MatteoLonardiUNITN/Tesi-SPaRKLE/Grafici/MCD Picchi/mcd_picchi.Rmd

---
title: "MDC Picchi"
author: "Matteo Lonardi"
date: "2026-03-17"
output: html_document
---

```{r setup, include=FALSE}
knitr::opts_chunk$set(echo = TRUE)
library(tidyverse)
library(scales) # Per gestire meglio le scale dei grafici
library(plotly)
library(tidyverse)
library(modelr)
library(minpack.lm)
```

```{r}
# Libreria
library(plotly)

# -----------------------------
# Funzione MCD
# -----------------------------
mcd <- function(a, b) {
  if (b == 0) return(a)
  Recall(b, a %% b)
}

mcd_vettore <- function(v) {
  Reduce(mcd, v)
}

# -----------------------------
# Lista file
# -----------------------------
files <- sprintf("files/tek%04dCH1.csv", 21:59)

# -----------------------------
# Estrazione massimi
# -----------------------------
massimi <- sapply(files, function(f) {
  dati <- read.csv(f, skip = 20)
  max(dati$CH1, na.rm = TRUE)
})

soglia_max <- 0.004

massimi_filtrati <- massimi[massimi <= soglia_max]

# Rimuovi eventuali NA
massimi_filtrati <- na.omit(massimi_filtrati)

cat("Massimi filtrati:\n")
print(massimi_filtrati)

# -----------------------------
# MCD sui dati filtrati
# -----------------------------
scala <- 1e6   # microvolt
massimi_int <- round(massimi_filtrati * scala)

mcd_val <- mcd_vettore(massimi_int)
mcd_volt <- mcd_val / scala

cat("MCD (volt):", mcd_volt, "\n")

# -----------------------------
# Istogramma
# -----------------------------
nbins <- 20

fig <- plot_ly(
  x = massimi_filtrati,
  type = "histogram",
  nbinsx = nbins
)

fig <- fig %>% layout(
  title = "Istogramma dei picchi massimi filtrati (CH1)",
  xaxis = list(title = "Tensione (V)"),
  yaxis = list(title = "Conteggi")
)

fig
```

```{r}
# Librerie
library(plotly)

# -----------------------------
# 1. Lista file
# -----------------------------
files <- sprintf("files/tek%04dCH1.csv", 21:59)

# -----------------------------
# 2. Estrazione massimi
# -----------------------------
massimi <- sapply(files, function(f) {
  dati <- read.csv(f, skip = 20)
  max(dati$CH1, na.rm = TRUE)
})

massimi <- na.omit(massimi)

cat("Massimi originali:\n")
print(massimi)

# -----------------------------
# 3. Filtro (togli outlier > 0.002 V)
# -----------------------------
soglia_max <- 0.002
massimi_filtrati <- massimi[massimi <= soglia_max]

cat("Massimi filtrati:\n")
print(massimi_filtrati)

# -----------------------------
# 4. Clustering (4 celle)
# -----------------------------
set.seed(1)
k <- kmeans(massimi_filtrati, centers = 4)

# Centri dei cluster (ordinati)
centri <- sort(k$centers[,1])

cat("Centri cluster (V):\n")
print(centri)

# -----------------------------
# 5. Stima tensione cella
# -----------------------------
differenze <- diff(centri)

cat("Differenze tra cluster:\n")
print(differenze)

cella <- median(differenze)

cat("Stima tensione cella (V):", cella, "\n")

# -----------------------------
# 6. Istogramma con linee cluster
# -----------------------------
nbins <- 50

fig <- plot_ly(
  x = massimi_filtrati,
  type = "histogram",
  nbinsx = nbins
)

# Creazione linee verticali
shapes_list <- lapply(centri, function(c) {
  list(
    type = "line",
    x0 = c,
    x1 = c,
    y0 = 0,
    y1 = 1,
    yref = "paper",  # tutta l'altezza del grafico
    line = list(dash = "dash")
  )
})

fig <- fig %>% layout(
  title = "Istogramma + cluster (SiPM)",
  xaxis = list(title = "Tensione (V)"),
  yaxis = list(title = "Conteggi"),
  shapes = shapes_list
)

fig
```
