MatteoLonardiUNITN/Tesi-SPaRKLE/Grafici/LaTeX-graphics/particelle_alpha00.pdf

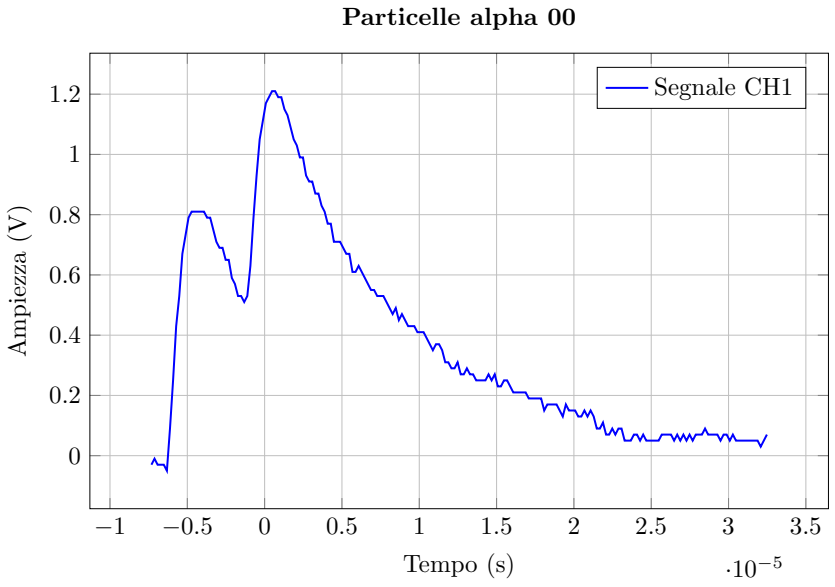
[picture p30: figure]
Tempo (s); Ampiezza (V); Particelle alpha 00; Segnale CH1
