MatteoLonardiUNITN/Tesi-SPaRKLE/Grafici/LaTeX-graphics/particelle_alpha01.pdf

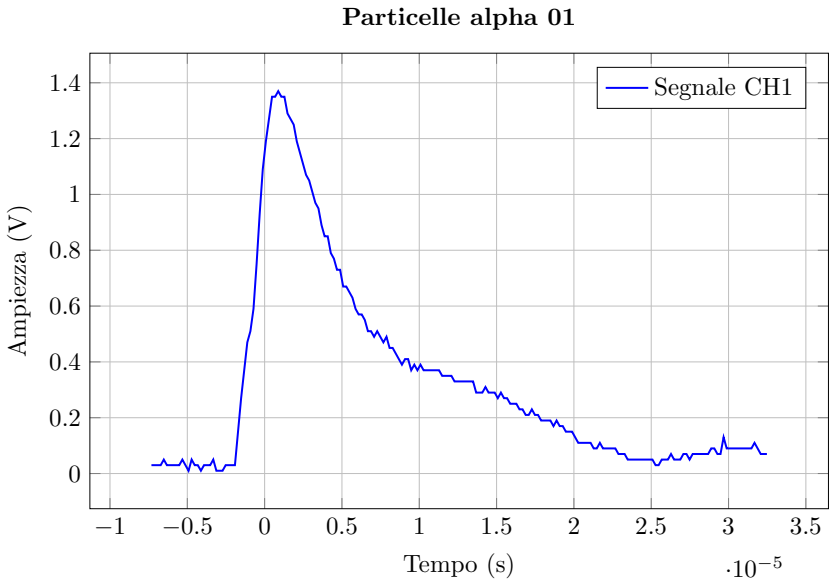
[picture p31: figure]
Tempo (s); Ampiezza (V); Particelle alpha 01; Segnale CH1
