MatteoLonardiUNITN/Tesi-SPaRKLE/Grafici/LaTeX-graphics/particelle_alpha02.pdf

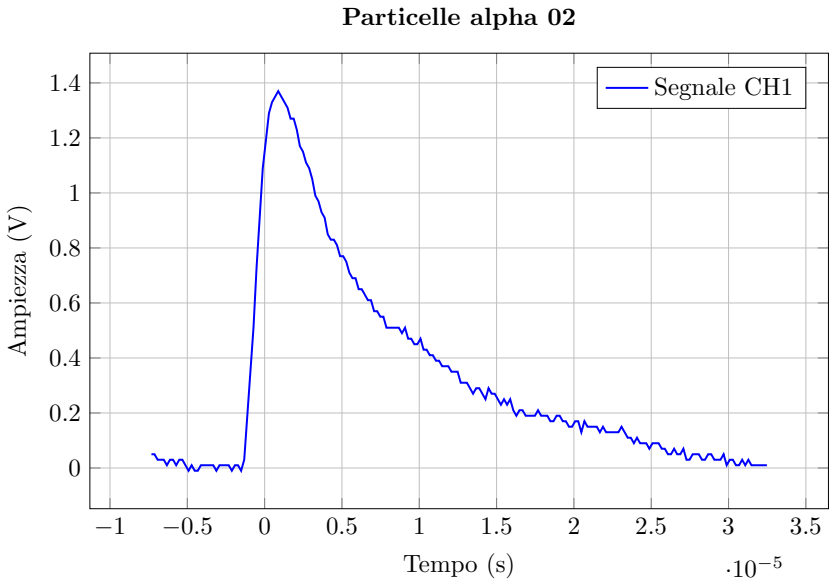
[picture p32: figure]
Tempo (s); Ampiezza (V); Particelle alpha 02; Segnale CH1
