MatteoLonardiUNITN/Tesi-SPaRKLE/Grafici/LaTeX-graphics/particelle_alpha03.pdf

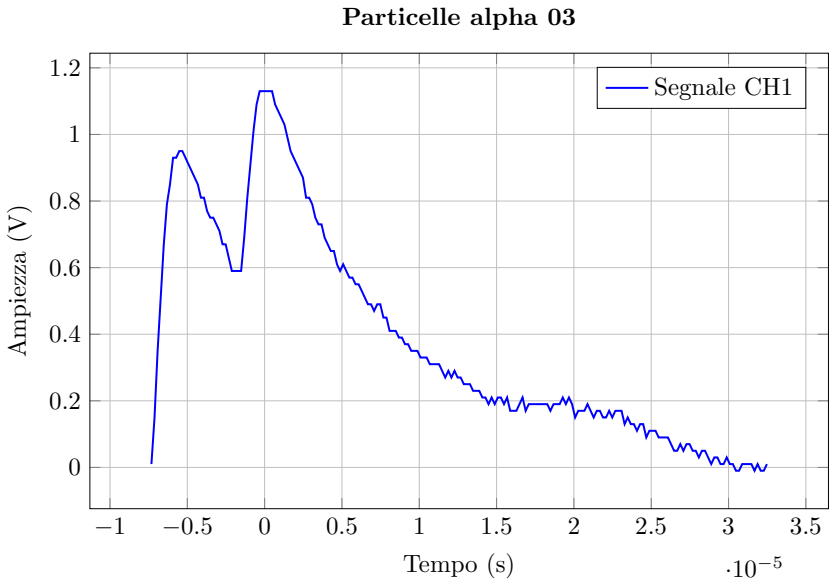
[picture p33: figure]
Tempo (s); Ampiezza (V); Particelle alpha 03; Segnale CH1
