MatteoLonardiUNITN/Tesi-SPaRKLE/Grafici/Regressione/backup_files/tek00000.png

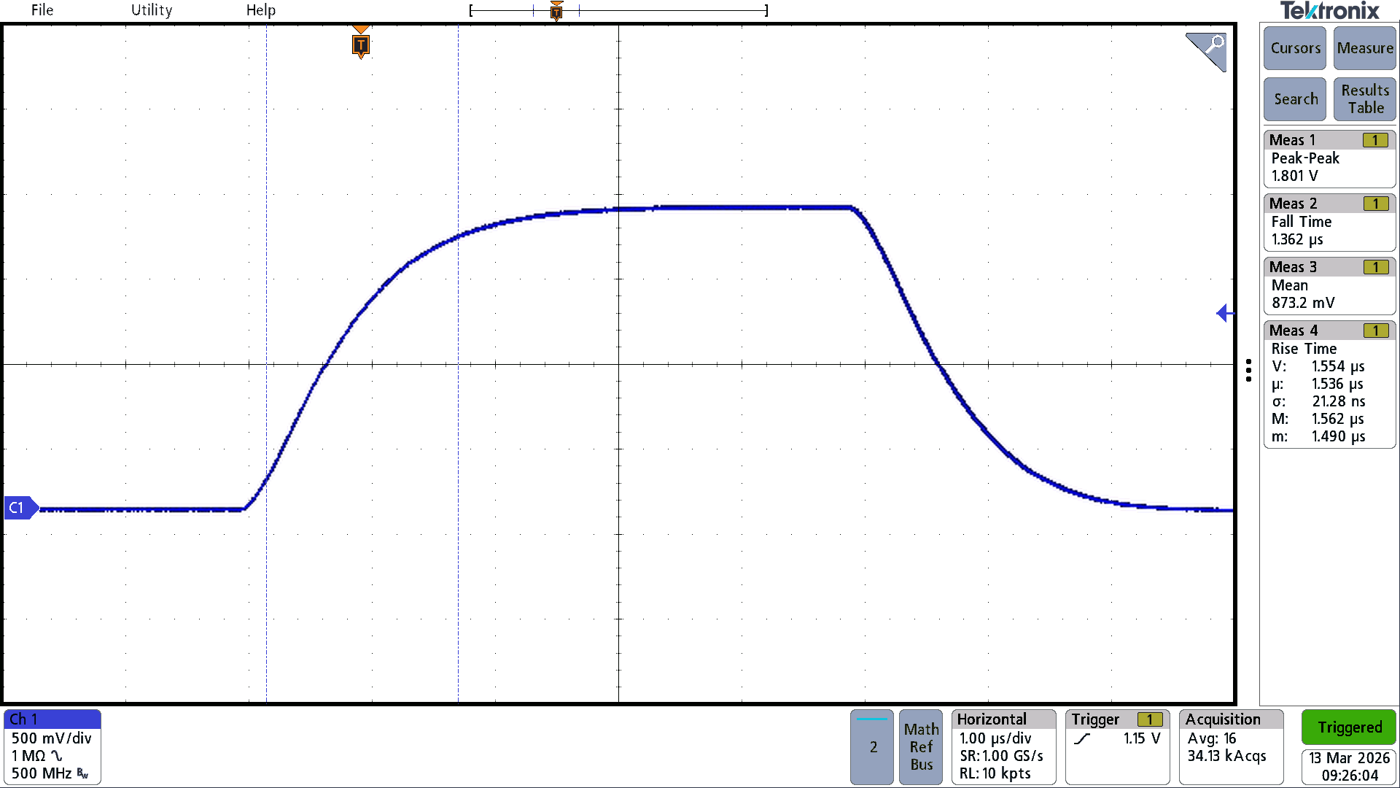
Grafici/Regressione/backup_files/tek00000.png
