MatteoLonardiUNITN/Tesi-SPaRKLE/Grafici/Regressione/backup_files/tek00001.png

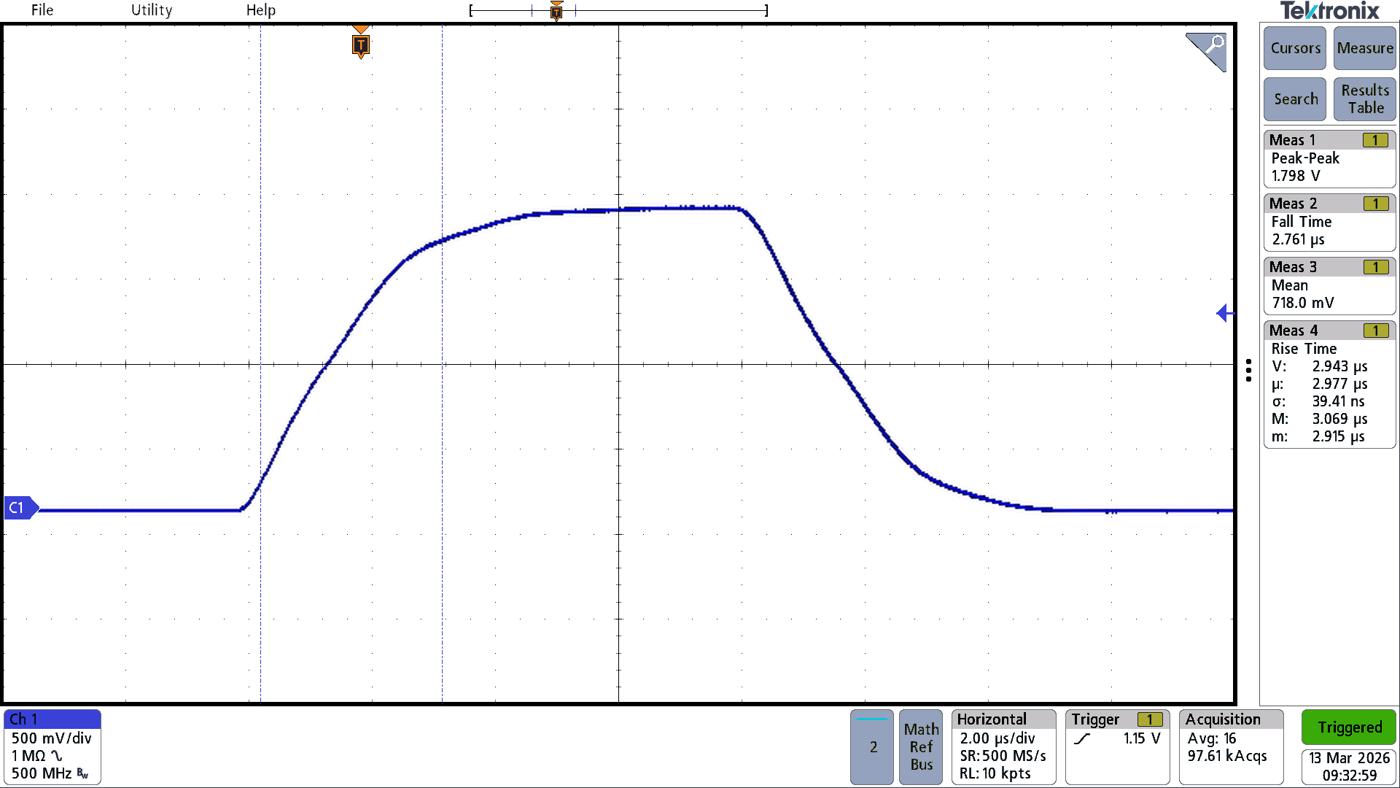
Grafici/Regressione/backup_files/tek00001.png
