MatteoLonardiUNITN/Tesi-SPaRKLE/Grafici/Regressione/backup_files/tek00002.png

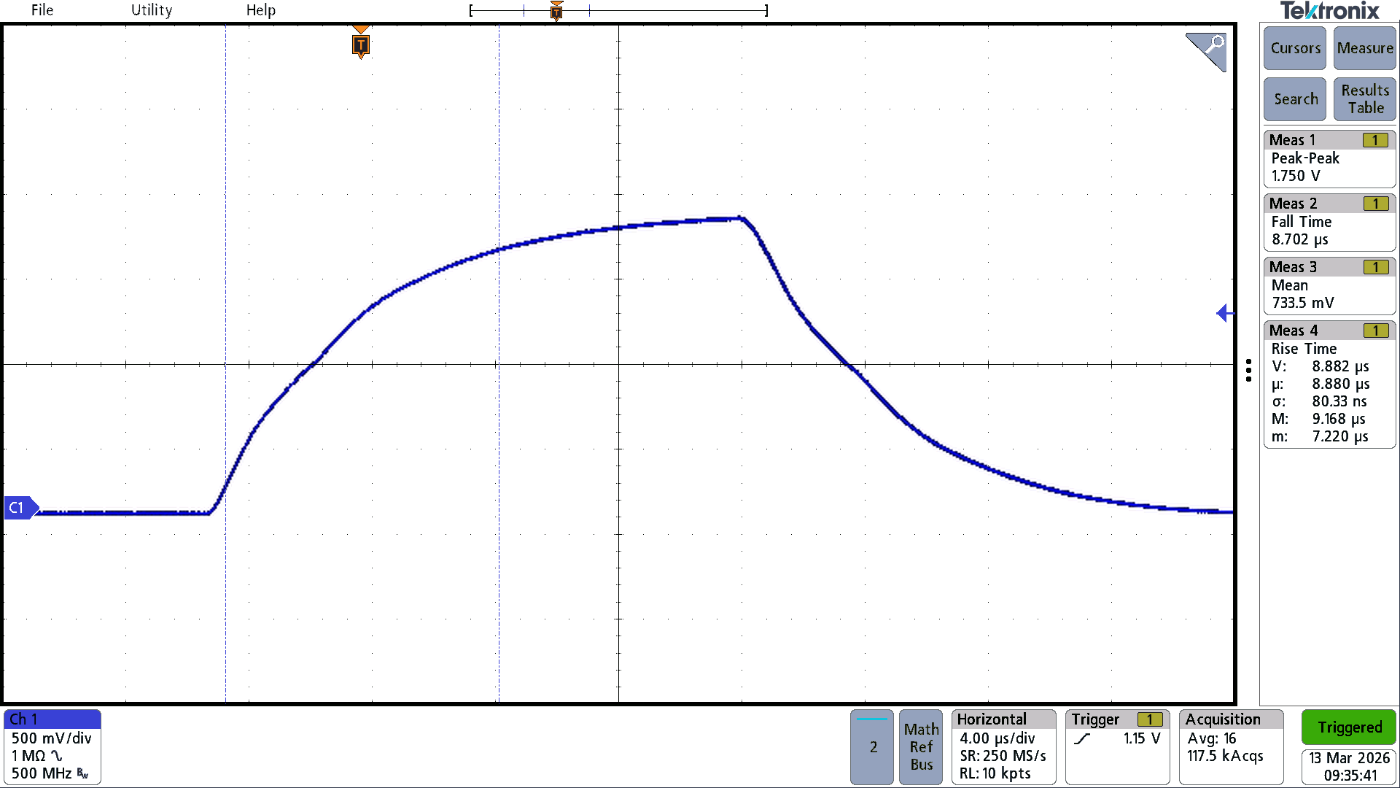
Grafici/Regressione/backup_files/tek00002.png
