MatteoLonardiUNITN/Tesi-SPaRKLE/Grafici/Regressione/backup_files/tek00003.png

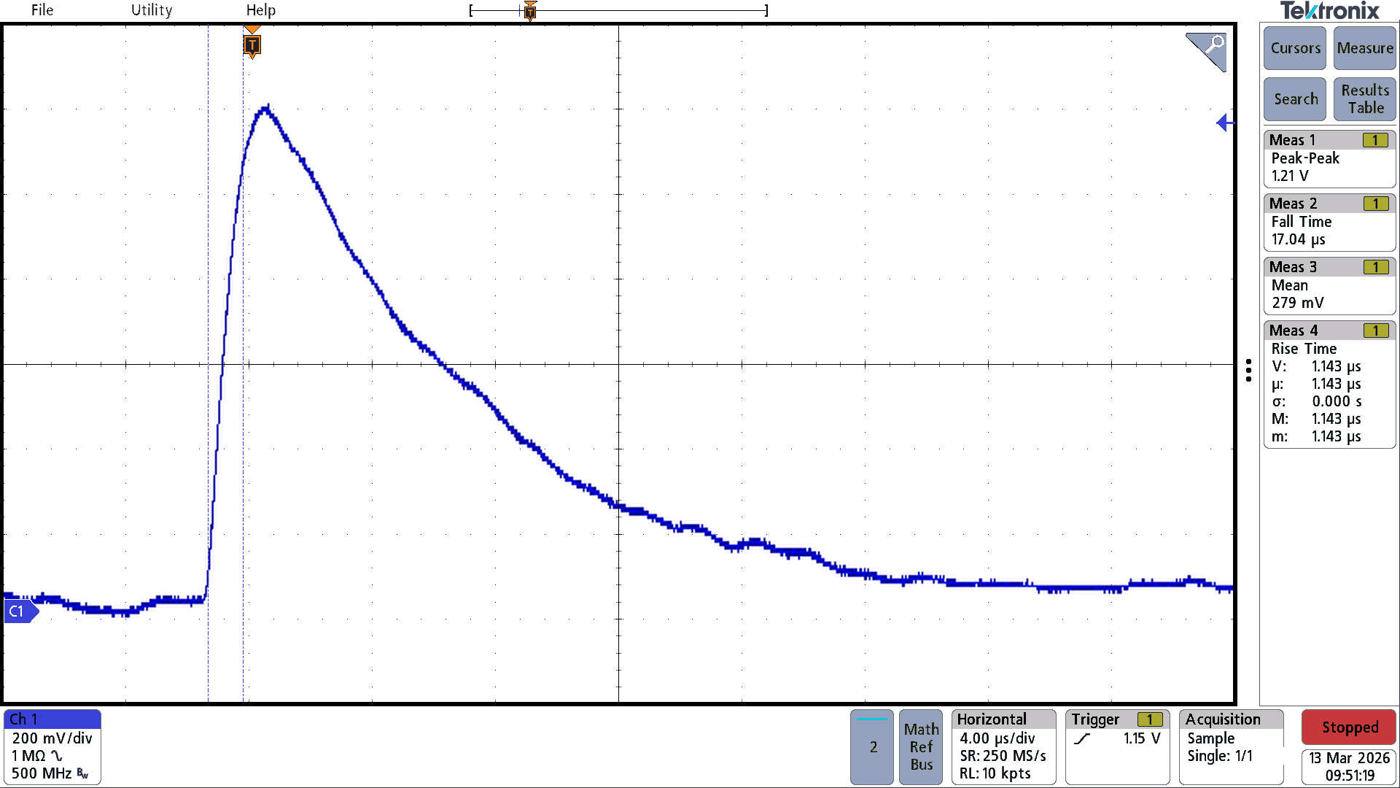
Grafici/Regressione/backup_files/tek00003.png
