MatteoLonardiUNITN/Tesi-SPaRKLE/Grafici/Regressione/backup_files/tek00004.png

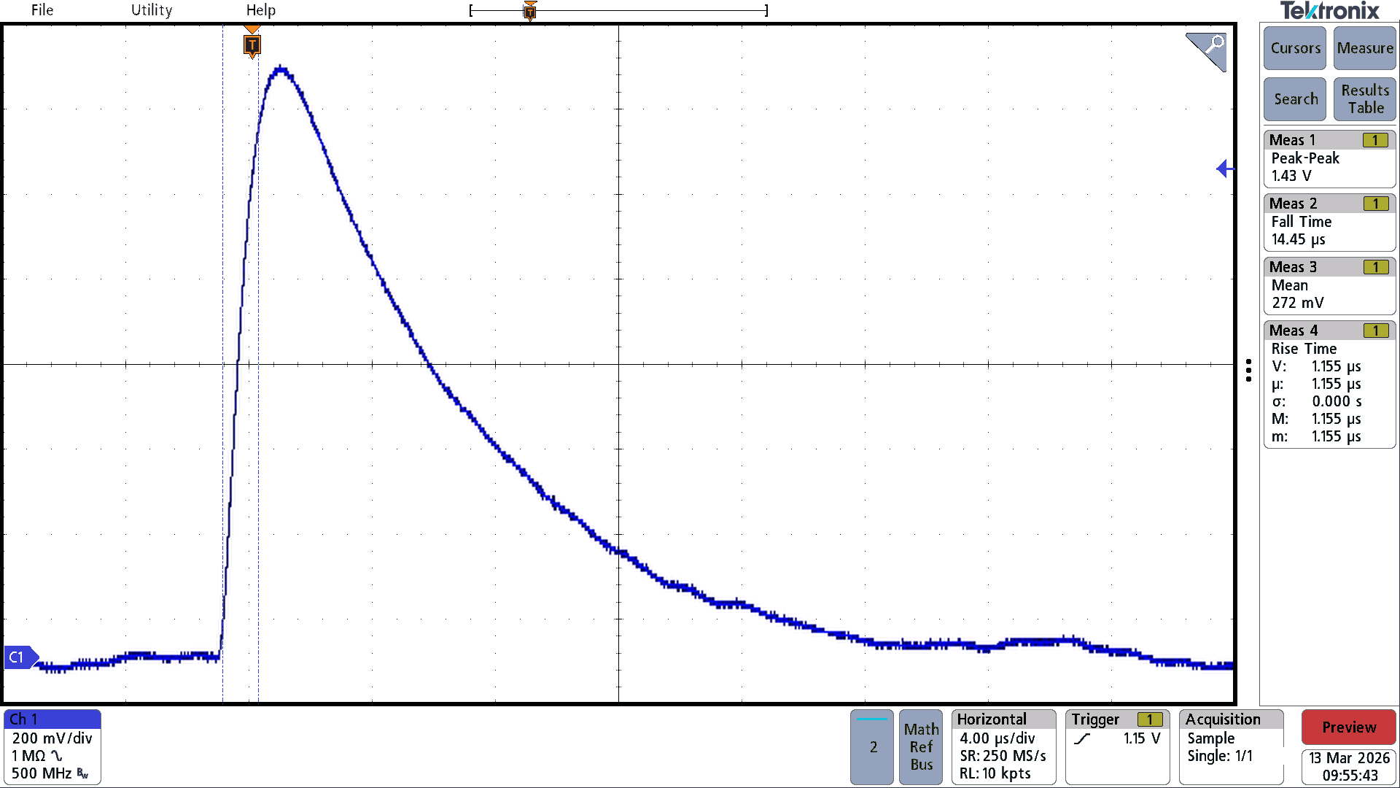
Grafici/Regressione/backup_files/tek00004.png
