MatteoLonardiUNITN/Tesi-SPaRKLE/Grafici/Regressione/Regressione_Caratterizzazione_Completo/confronto_currentmode_voltagemode_8_SiPM.png

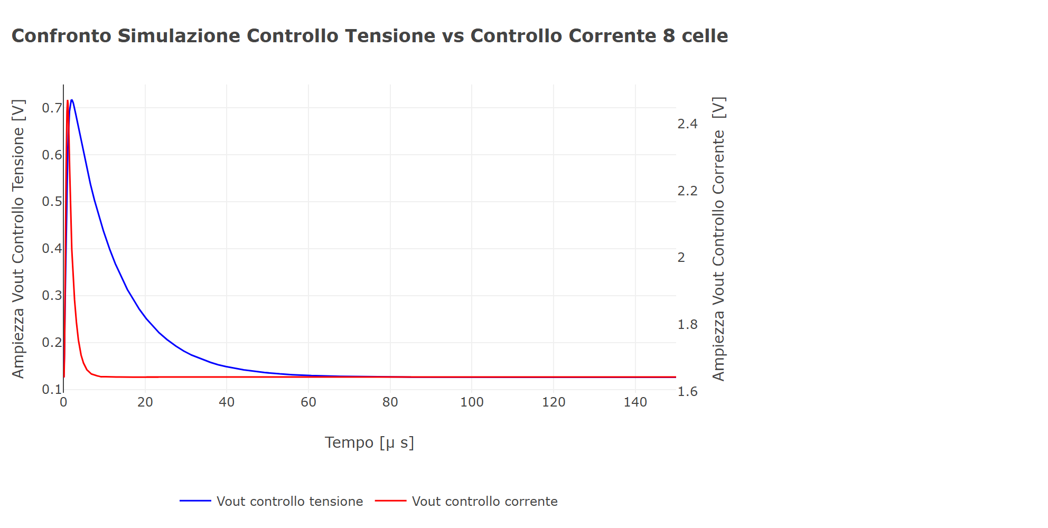
Grafici/Regressione/Regressione_Caratterizzazione_Completo/confronto_currentmode_voltagemode_8_SiPM.png
