MatteoLonardiUNITN/Tesi-SPaRKLE/LaTeX/Immagini/currentmodebode.PNG

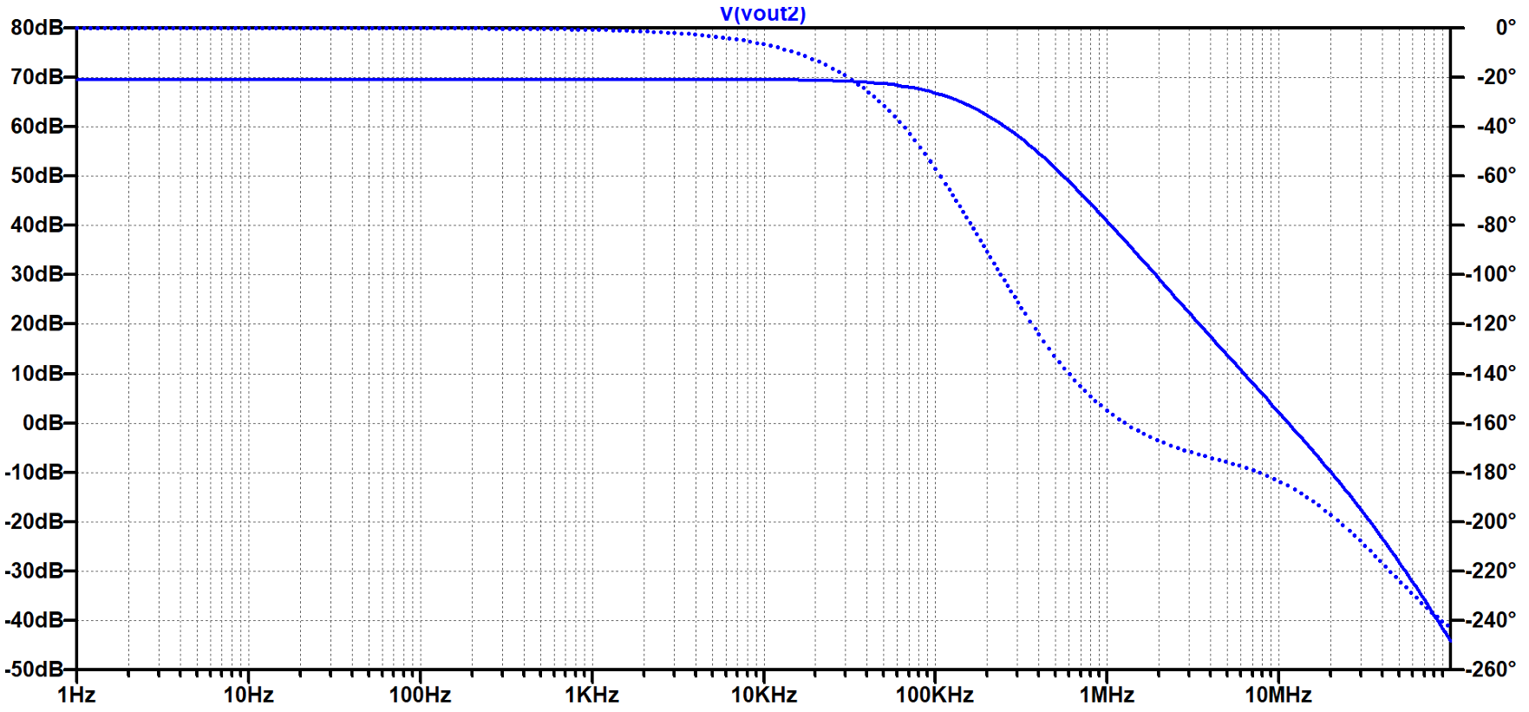
LaTeX/Immagini/currentmodebode.PNG
