MatteoLonardiUNITN/Tesi-SPaRKLE/LaTeX/Immagini/currentmodecircuit.PNG

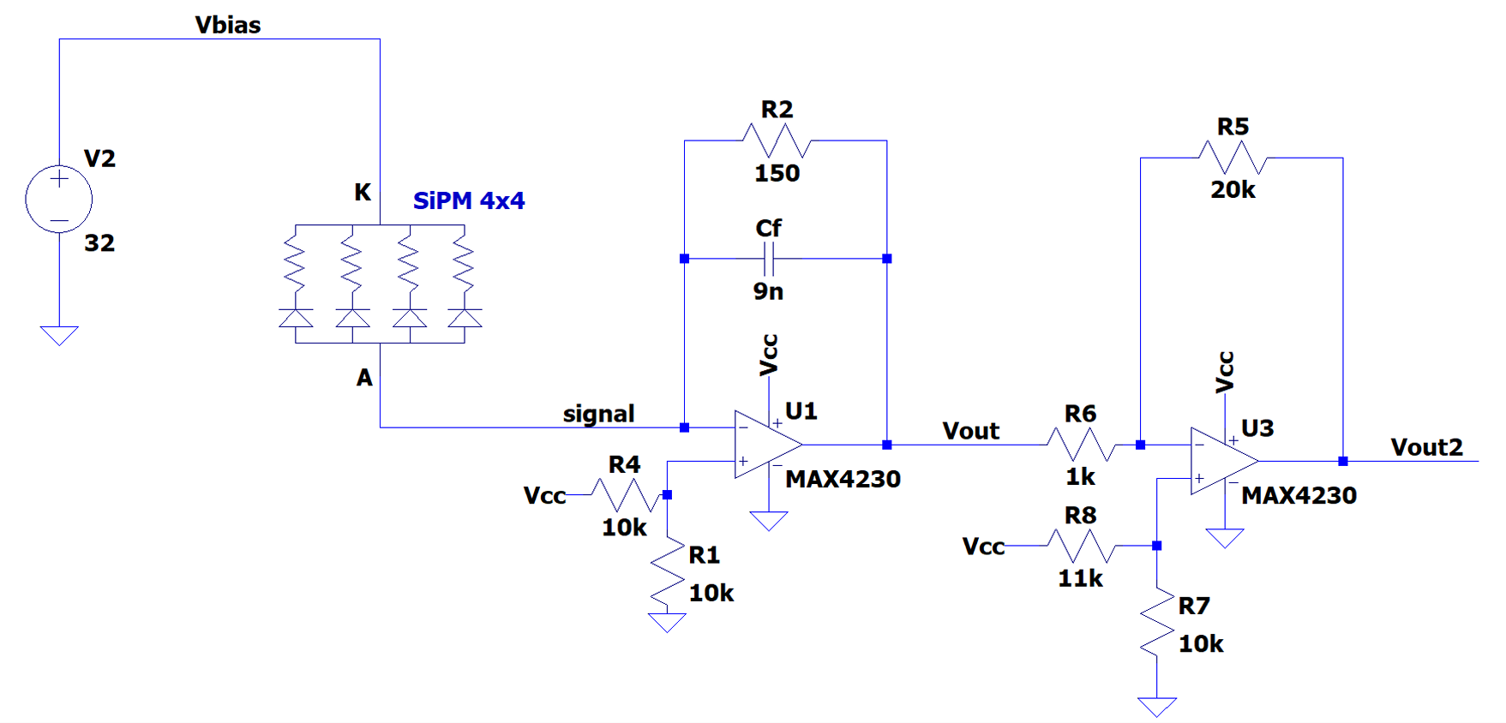
LaTeX/Immagini/currentmodecircuit.PNG
