MatteoLonardiUNITN/Tesi-SPaRKLE/LaTeX/Immagini/currentmodetransient1.PNG

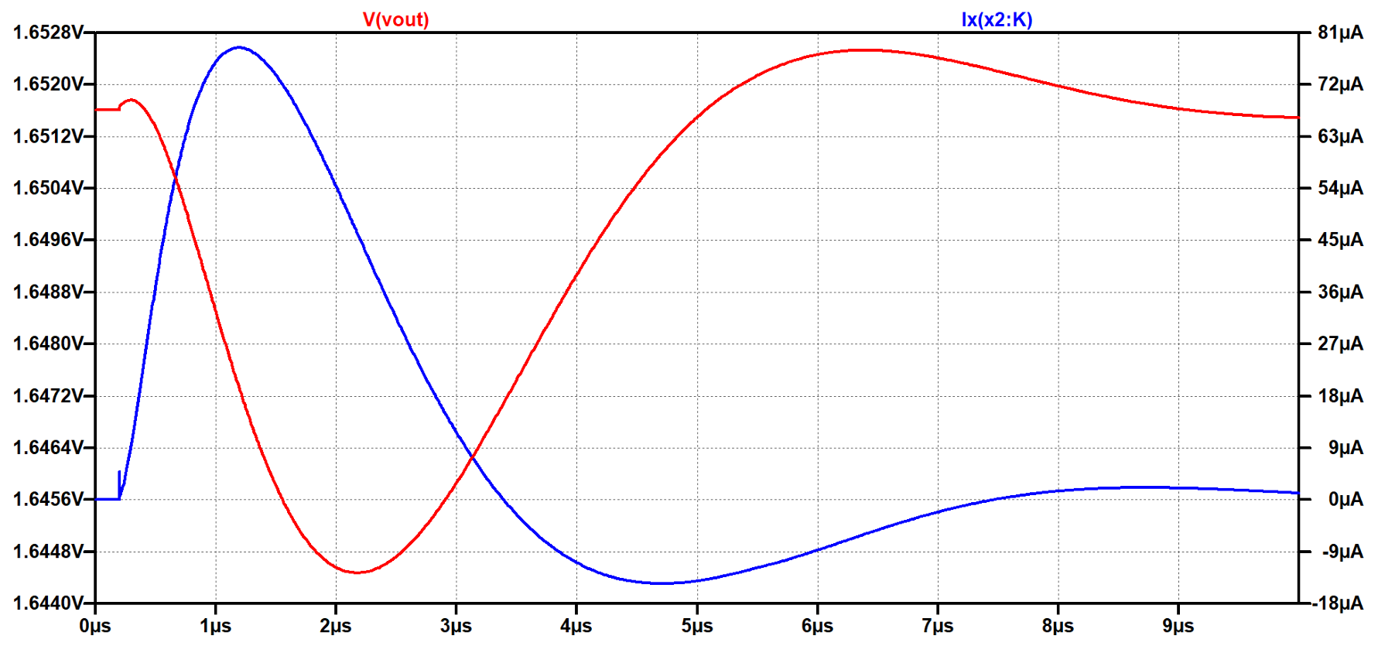
LaTeX/Immagini/currentmodetransient1.PNG
