MatteoLonardiUNITN/Tesi-SPaRKLE/LaTeX/Immagini/currentmodetransient2.PNG

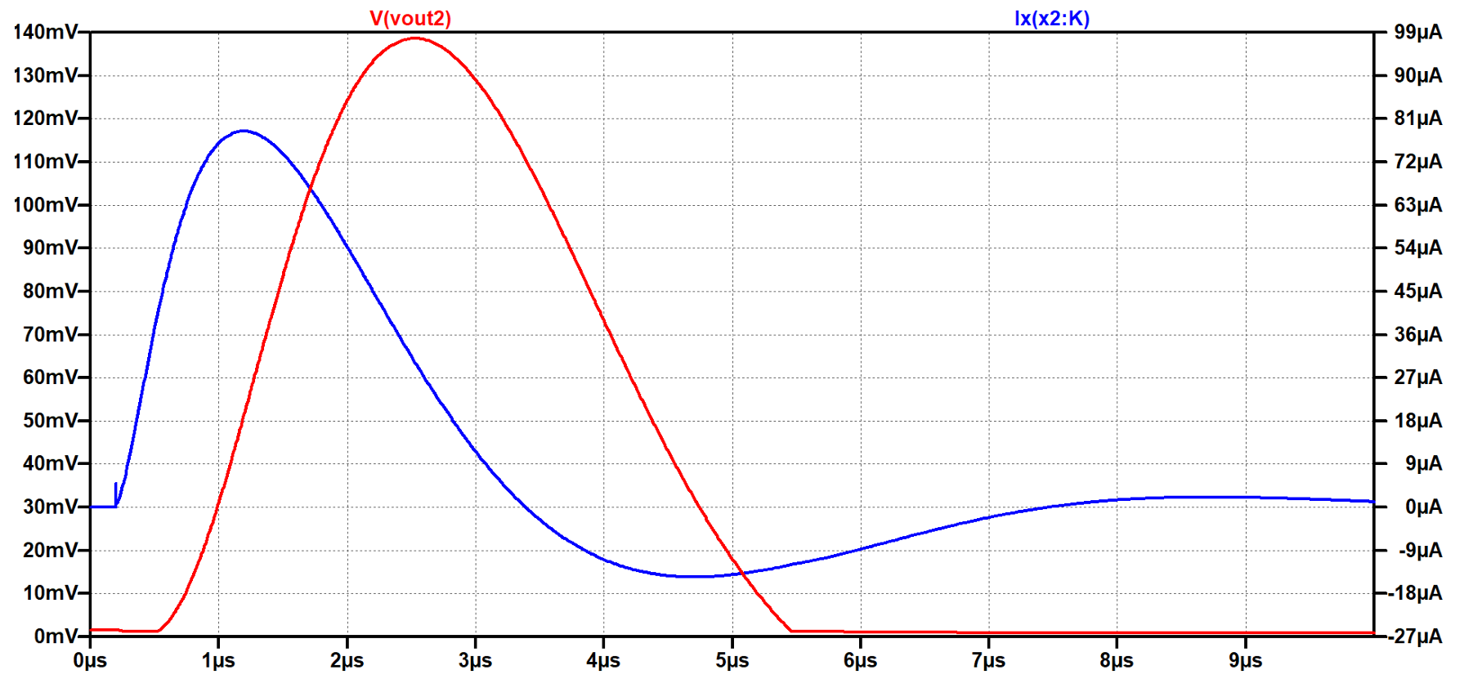
LaTeX/Immagini/currentmodetransient2.PNG
