MatteoLonardiUNITN/Tesi-SPaRKLE/LaTeX/Immagini/gaggimage.PNG

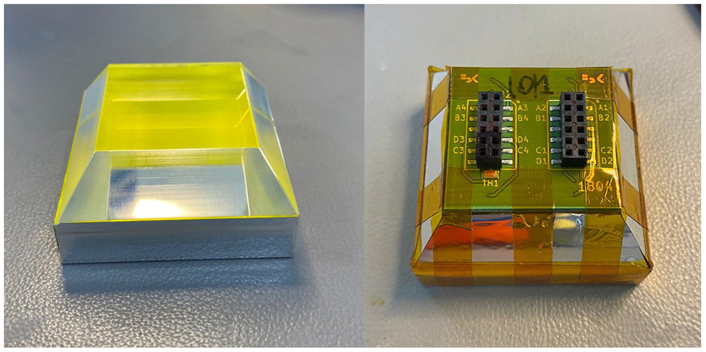
LaTeX/Immagini/gaggimage.PNG
