MatteoLonardiUNITN/Tesi-SPaRKLE/LaTeX/Immagini/mio_circuito_controllo_tensione.png

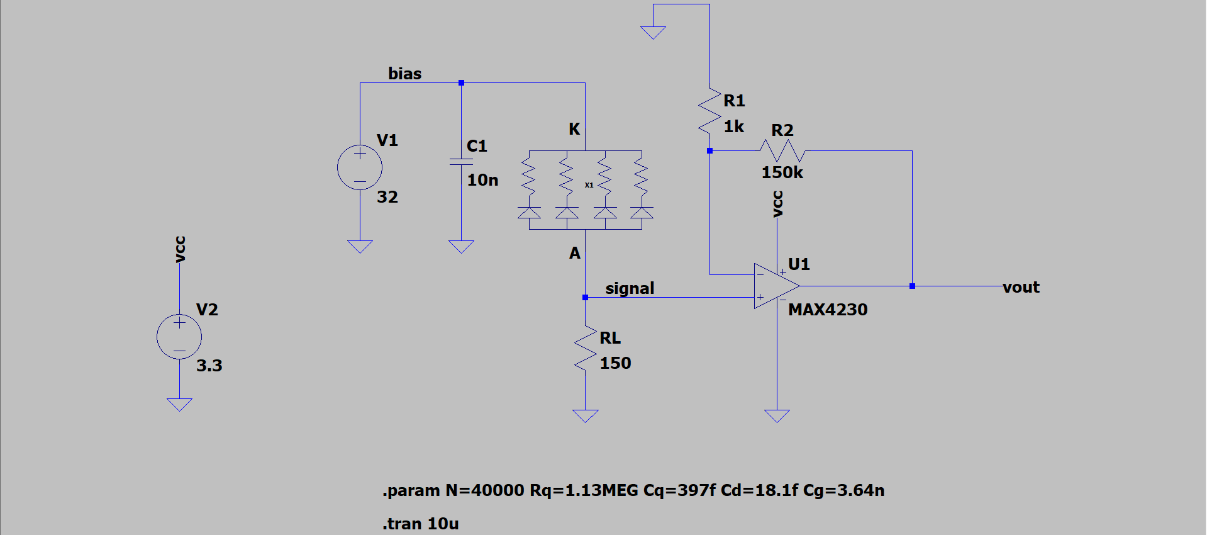
LaTeX/Immagini/mio_circuito_controllo_tensione.png
