MatteoLonardiUNITN/Tesi-SPaRKLE/LaTeX/Immagini/mio_circuito_sipm_equivalente.png

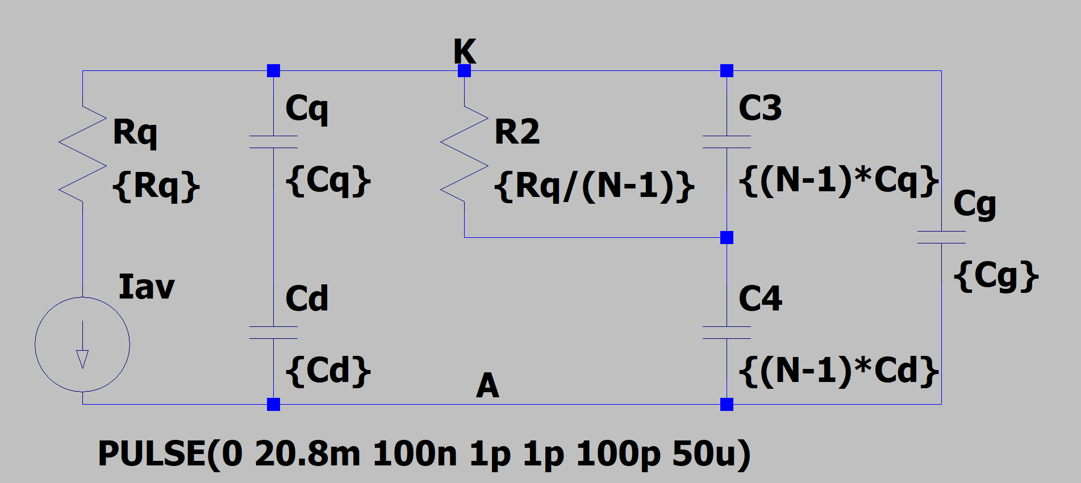
LaTeX/Immagini/mio_circuito_sipm_equivalente.png
