MatteoLonardiUNITN/Tesi-SPaRKLE/LaTeX/Immagini/mio_plot_controllo_corrente.png

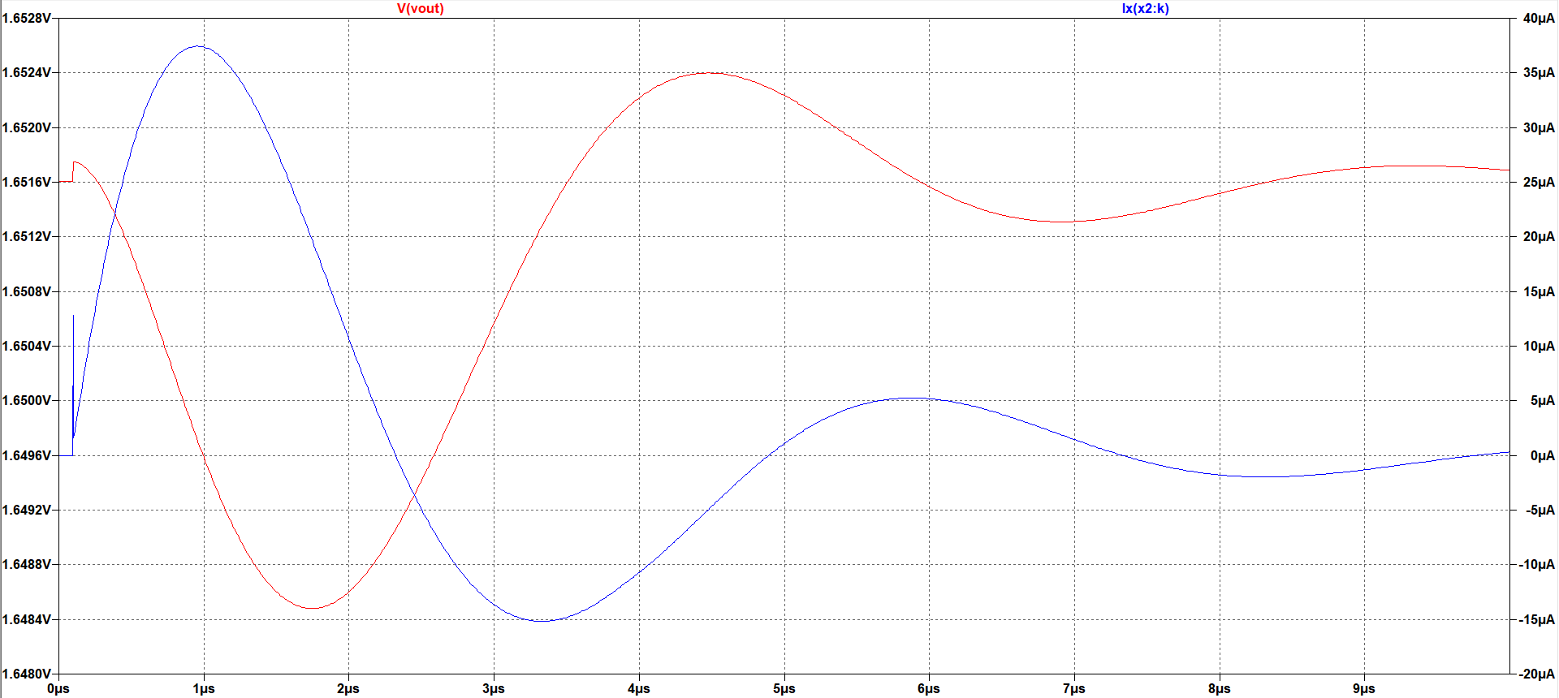
LaTeX/Immagini/mio_plot_controllo_corrente.png
