MatteoLonardiUNITN/Tesi-SPaRKLE/LaTeX/Immagini/mio_plot_controllo_tensione.png

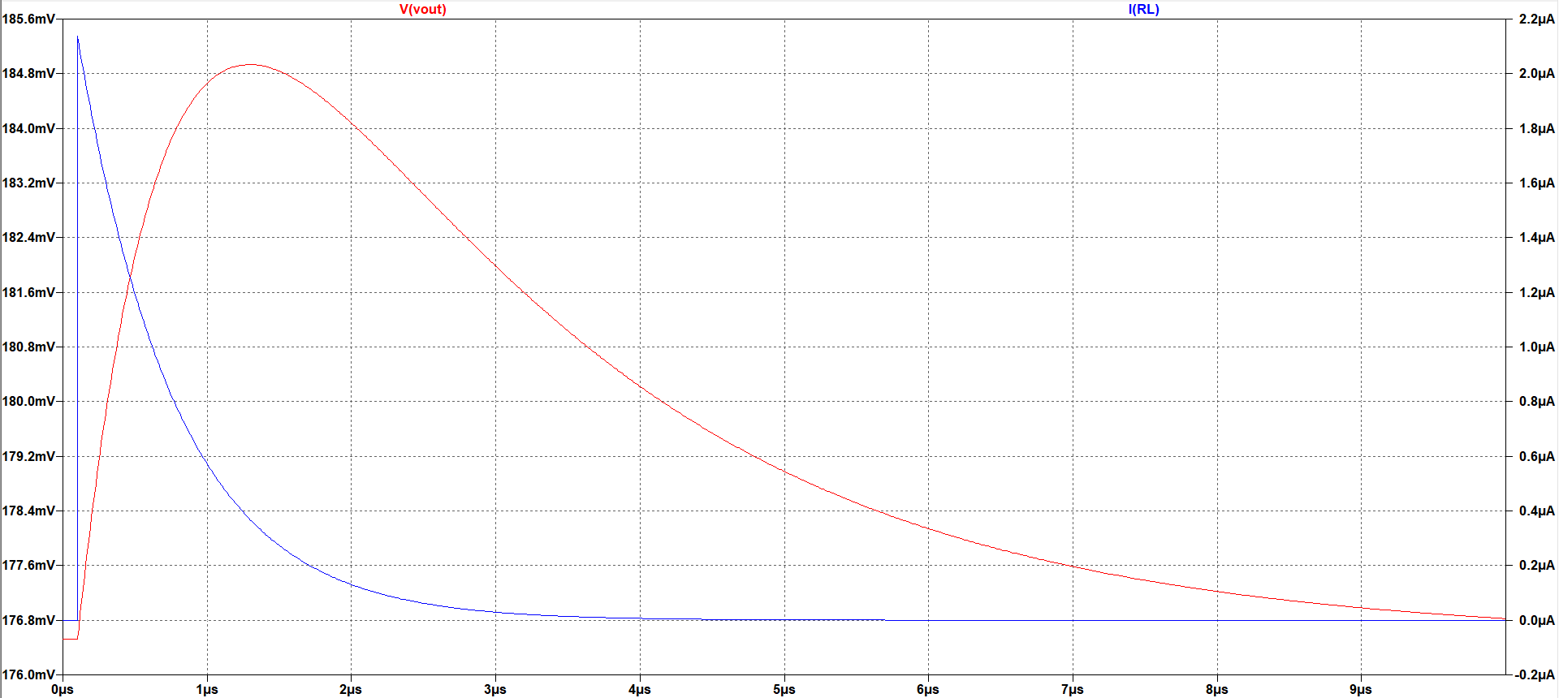
LaTeX/Immagini/mio_plot_controllo_tensione.png
