MatteoLonardiUNITN/Tesi-SPaRKLE/LaTeX/Immagini/voltagemodecircuit.PNG

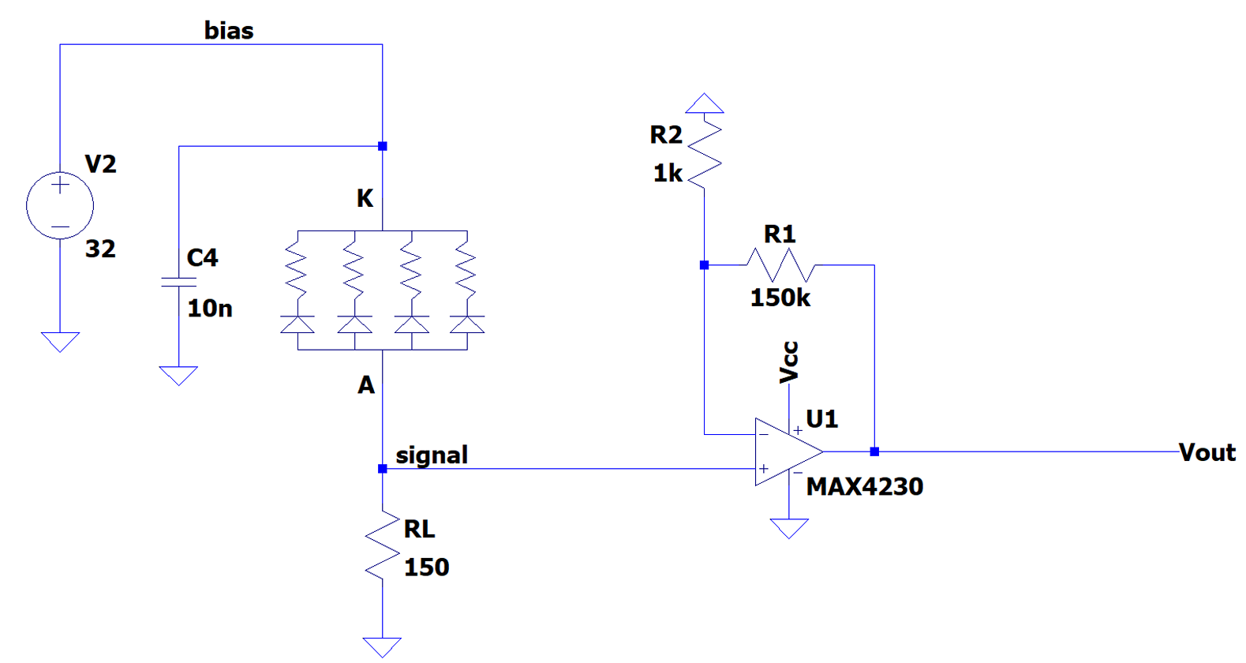
LaTeX/Immagini/voltagemodecircuit.PNG
