MatteoLonardiUNITN/Tesi-SPaRKLE/LaTeX/Immagini/voltagemodetransient.PNG

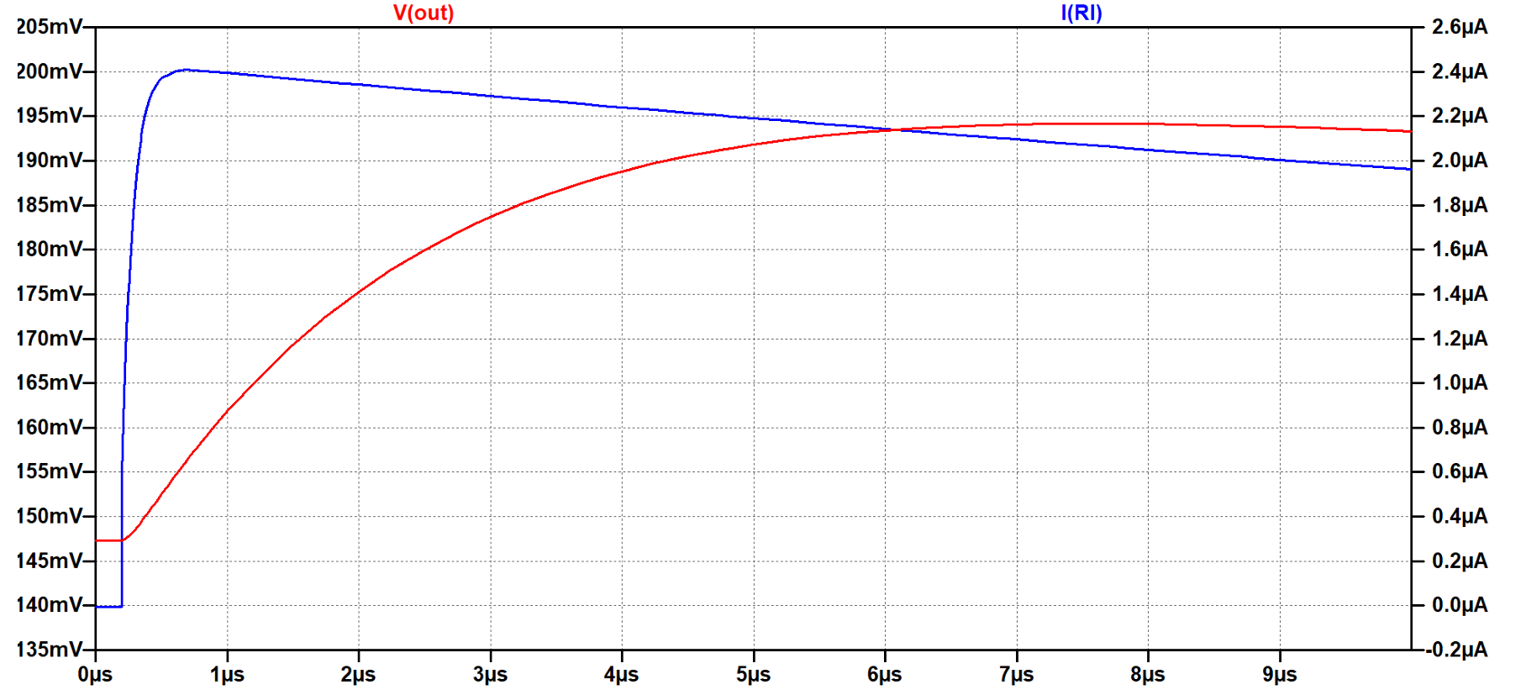
LaTeX/Immagini/voltagemodetransient.PNG
