MatteoLonardiUNITN/Tesi-SPaRKLE/LaTeX/Immagini/vout2_controllo_corrente.png

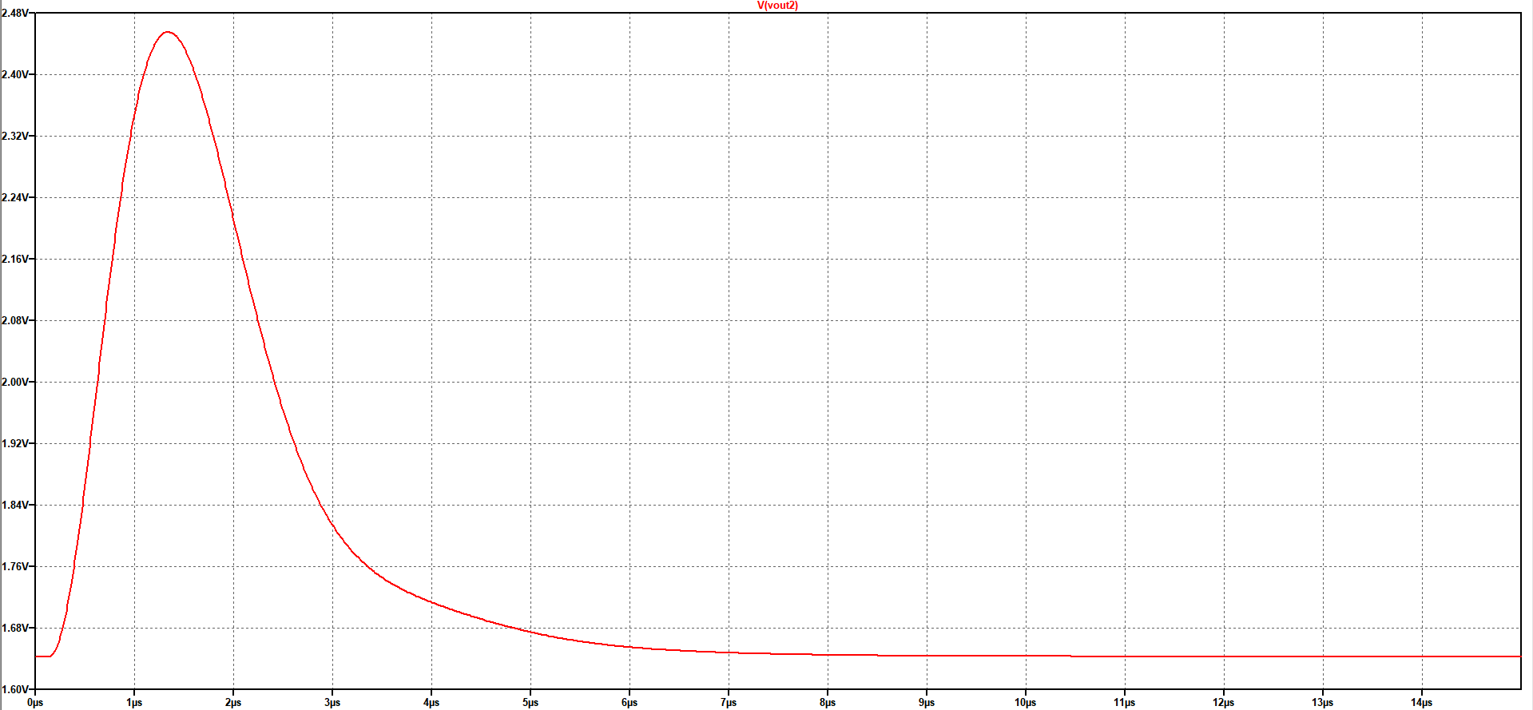
LaTeX/Immagini/vout2_controllo_corrente.png
