MatteoLonardiUNITN/Tesi-SPaRKLE/Scheda/prova/3D-Models/Download_STP_691213510002_rev1.stp

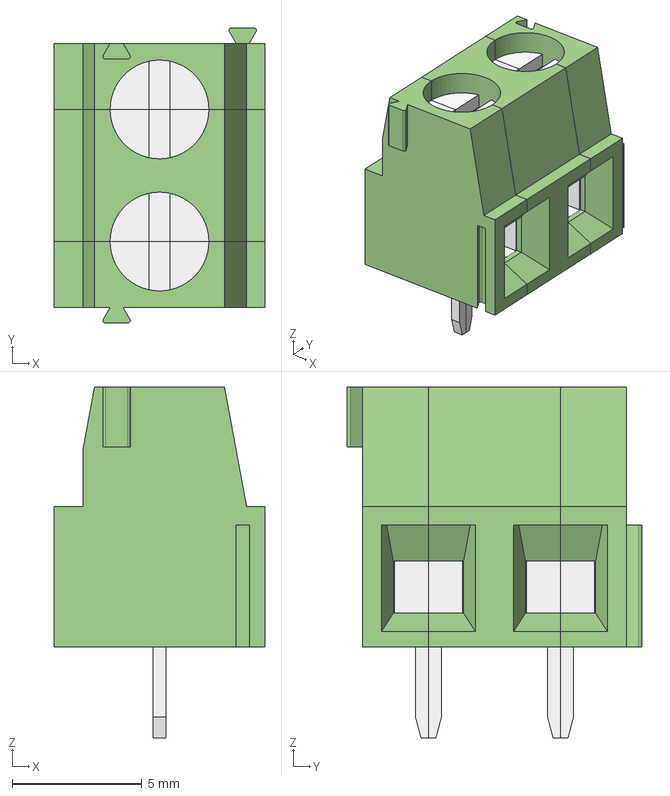
[picture p52: CAD file, 2026-04-14]
Scheda/prova/3D-Models/Download_STP_691213510002_rev1.stp
8.10 x 11.4 x 13.5 mm
CII5_08_SX_PRT.PRT
CII5_08_CNT_PRT.PRT
CII5_08_DX_PRT.PRT
