MatteoLonardiUNITN/Tesi-SPaRKLE/Scheda/prova/3D-Models/HJ-Tech-HJ-SMA175.STEP

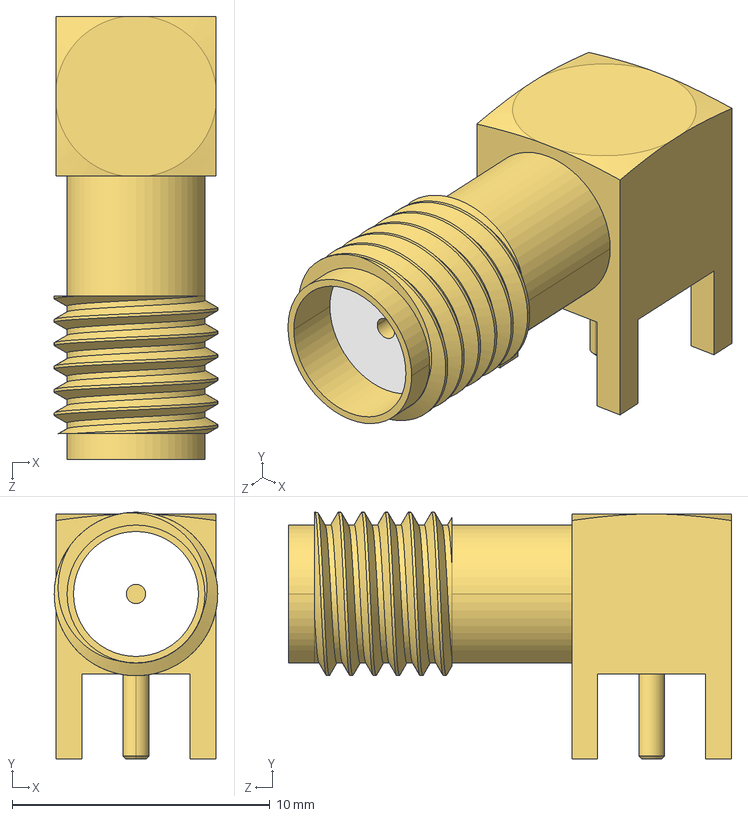
[picture p53: CAD file, 2026-04-14]
Scheda/prova/3D-Models/HJ-Tech-HJ-SMA175.STEP
6.35 x 9.57 x 17.2 mm
