MatteoLonardiUNITN/Tesi-SPaRKLE/Scheda/prova/3D-Models/ARRAYJ-30035-16P-PCB.step

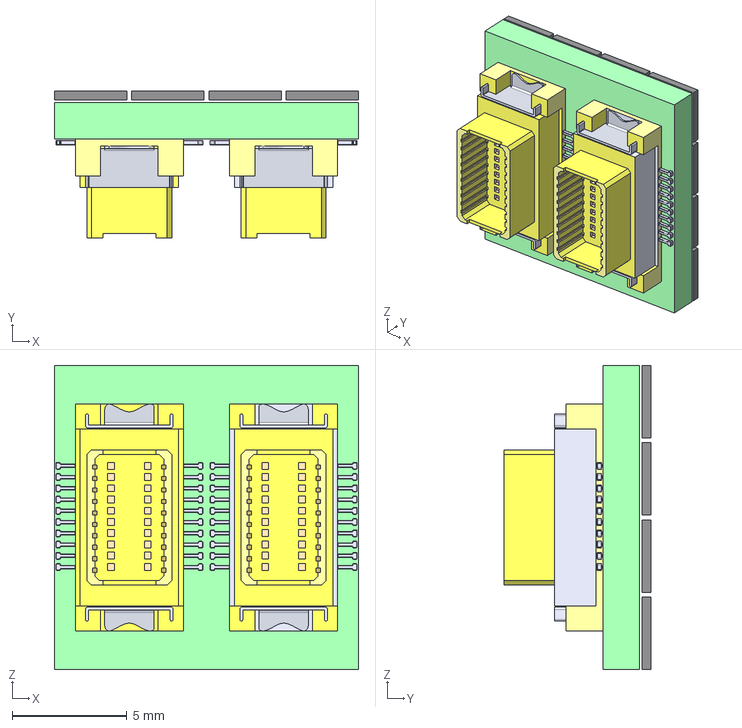
[picture p54: CAD file, 2026-04-14]
Scheda/prova/3D-Models/ARRAYJ-30035-16P-PCB.step
13.2 x 6.40 x 13.2 mm
