MatteoLonardiUNITN/Tesi-SPaRKLE/LTspice/Update/schematic.pdf

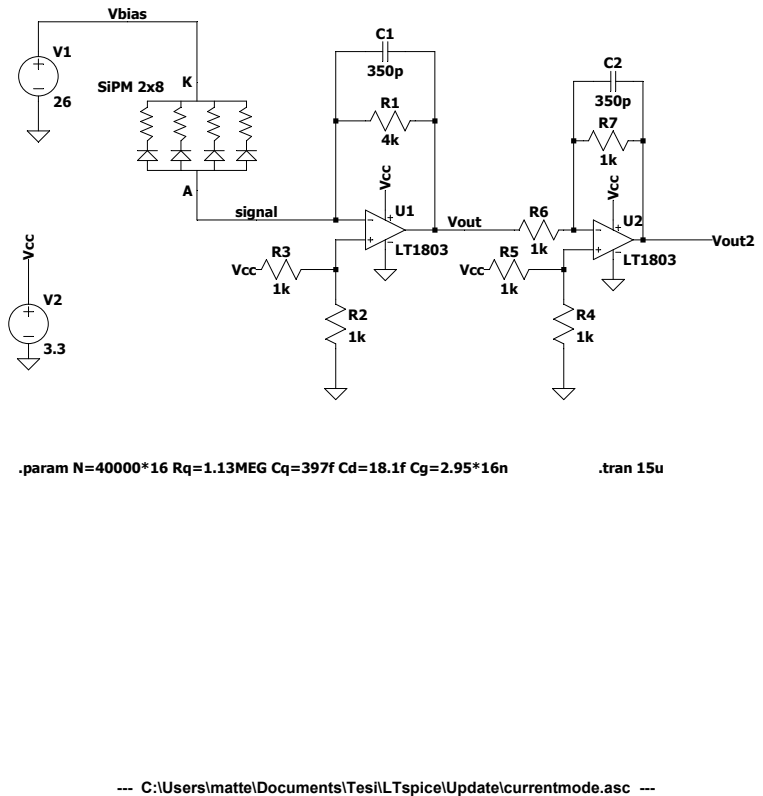
[picture p55: page 1]

--- C:\Users\matte\Documents\Tesi\LTspice\Update\currentmode.asc ---
