MatteoLonardiUNITN/Tesi-SPaRKLE/Grafici/LaTeX-graphics/sipm_alpha.pdf

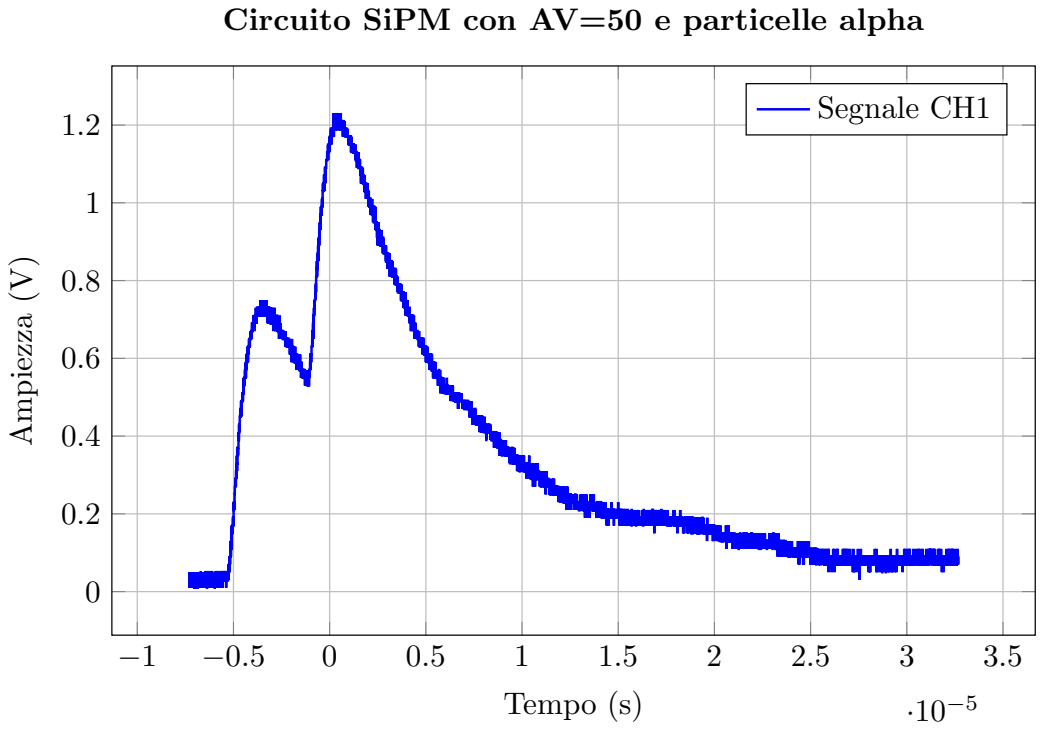
[picture p56: page 1]
Tempo (s); Ampiezza (V); Segnale CH1

Circuito SiPM con AV=50 e particelle alpha
