MatteoLonardiUNITN/Tesi-SPaRKLE/LTspice/Update/graph.pdf

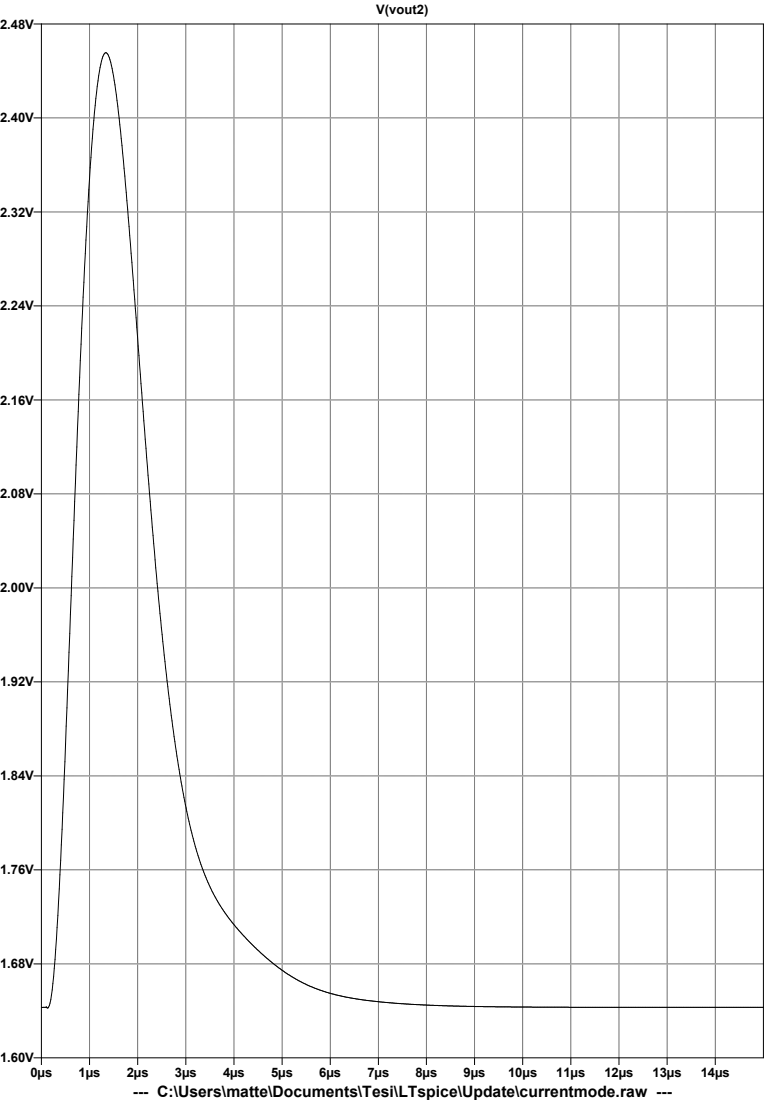
[picture p57: page 1]
V(vout2)

--- C:\Users\matte\Documents\Tesi\LTspice\Update\currentmode.raw ---
