MatteoLonardiUNITN/Tesi-SPaRKLE/Grafici/LaTeX-graphics/no_sipm_gradino.pdf

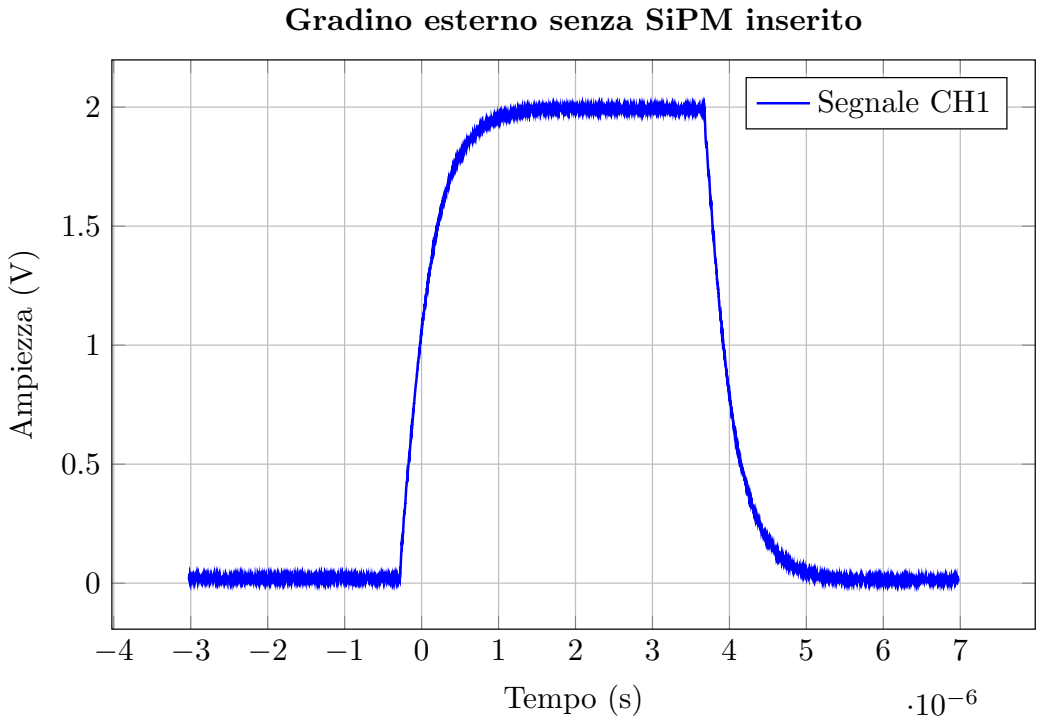
[picture p58: page 1]
Tempo (s); Ampiezza (V); Segnale CH1

Gradino esterno senza SiPM inserito
