MatteoLonardiUNITN/Tesi-SPaRKLE/Grafici/LaTeX-graphics/sipm_gradino.pdf

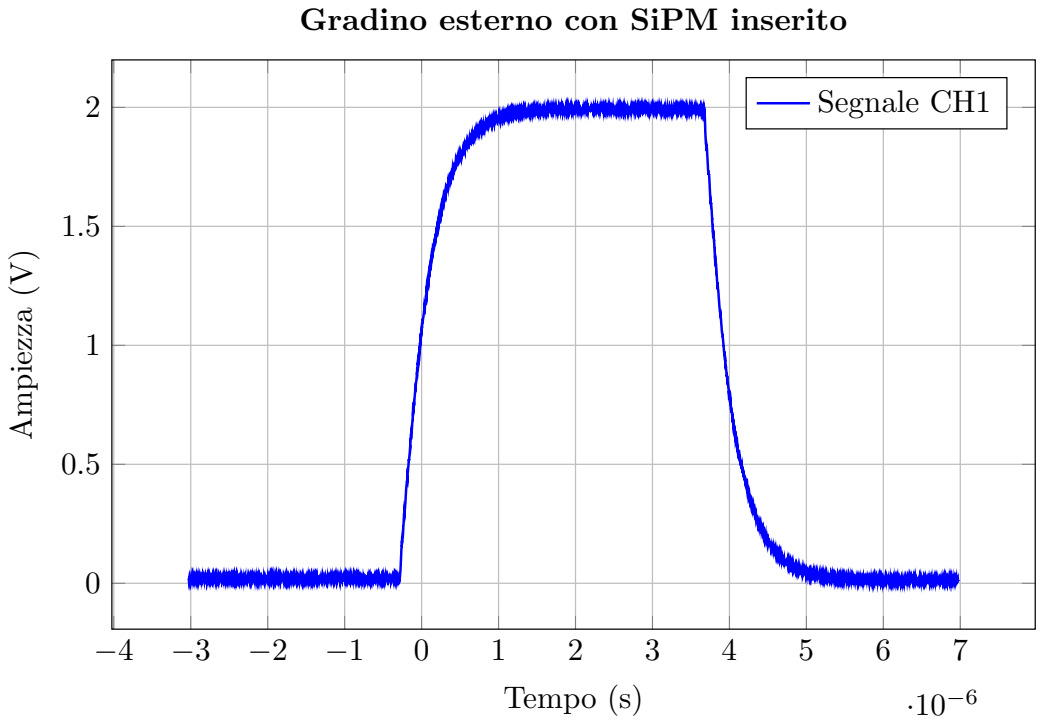
[picture p59: page 1]
Tempo (s); Ampiezza (V); Segnale CH1

Gradino esterno con SiPM inserito
