MatteoLonardiUNITN/Tesi-SPaRKLE/Grafici/Regressione/Regressione_Doppio_Exp/regressione_files/figure-latex/unnamed-chunk-12-1.pdf

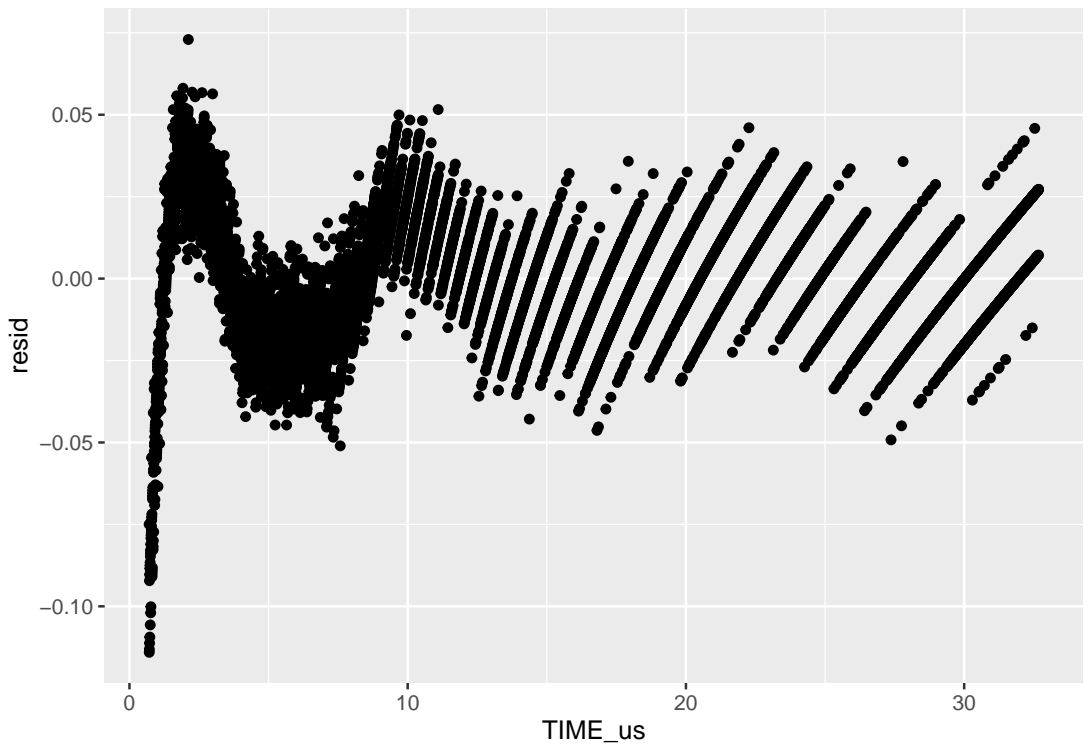
[picture p60: page 1]
TIME_us; resid
