MatteoLonardiUNITN/Tesi-SPaRKLE/Grafici/Regressione/Regressione_Doppio_Exp/regressione_files/figure-latex/unnamed-chunk-9-1.pdf

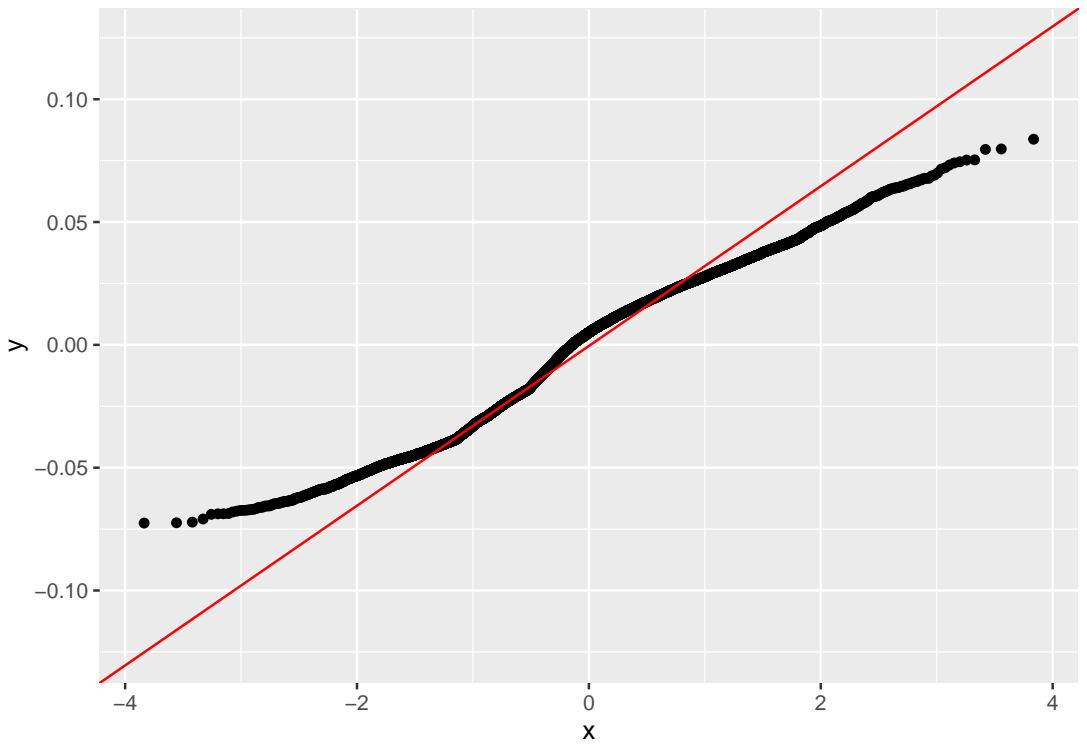
[picture p62: page 1]
