MatteoLonardiUNITN/Tesi-SPaRKLE/LTspice/Convertitori/Step_Down.asc

C1: cap; 1µ
C2: cap; 1µ
C5: cap; 10µ
C6: cap; .01µ
R1: res; 1k
Rload1: res; 500
U1: ADP124-3.3
U3: LT1761-3.3
V1: voltage; 5
V3: voltage; 5
Named nets: 0, Vout, Vin, OUT, IN
.tran 1
