MatteoLonardiUNITN/Tesi-SPaRKLE/LTspice/Update/confronto.asc

C1: cap; 100n
C2: cap; 100n
C5: cap; 10p
C6: cap; 100p
C7: cap; 100p
C8: cap; 350p
C9: cap; 350p
R1: res; 390
R2: res; 1k
R3: res; 51k
R4: res; 1k
R5: res; 1Meg
R6: res; 4k
R7: res; 1k
R8: res; 1k
R9: res; 1k
R10: res; 1k
R11: res; 1k
R12: res; 1k
U1: LT1803
U2: LT1803
U3: LT1803
V1: voltage; 26
V3: voltage; 26
V4: voltage; 3.3
X1: sipm_equivalente_controllo_tensione_pulse
X2: sipm_equivalente_controllo_tensione_pulse
Named nets: 0, vcc, Vout, Vcc, Vout2, Vbias
.tran 0 150u 0 10n
SiPM 1x4
.param N=40000*16 Rq=1.13MEG Cq=397f Cd=18.1f Cg=2.95*16n
C1 = 350p R1 = 4k C2 = 350p
SiPM 2x8
.options method=gear
