MatteoLonardiUNITN/Tesi-SPaRKLE/LTspice/Update/currentmode.asc

C1: cap; 350p
C2: cap; 350p
R1: res; 4k
R2: res; 1k
R3: res; 1k
R4: res; 1k
R5: res; 1k
R6: res; 1k
R7: res; 1k
U1: LT1803
U2: LT1803
V1: voltage; 26
V2: voltage; 3.3
X1: sipm_equivalente_controllo_tensione_pulse
Named nets: 0, Vcc, Vout, Vbias, signal, Vout2
.tran 15u
.param N=40000*16 Rq=1.13MEG Cq=397f Cd=18.1f Cg=2.95*16n
C1 = 350p R1 = 4k C2 = 350p
SiPM 2x8
