MatteoLonardiUNITN/Tesi-SPaRKLE/LTspice/Update/currentmode_v1.asc

C1: cap; 350p
C2: cap; 350p
C3: cap; 350p
C4: cap; 350p
R1: res; 4k
R2: res; 500
R3: res; 500
R4: res; 4k
R6: res; 1k
R7: res; 1k
R9: res; 1k
R10: res; 1k
U1: LT1803
U2: LT1803
U3: LT1803
U4: LT1803
V2: voltage; 26
V4: voltage; 3.3
X1: sipm_equivalente_controllo_tensione_pulse
X2: sipm_equivalente_controllo_tensione_pulse
Named nets: Vcc, VoutB, signalB, 0, Vout2B, VoutA, signalA, Vout2A, VREF, VBias
.tran 15u
.param N=40000*16 Rq=1.13MEG Cq=397f Cd=18.1f Cg=2.95*16n
C1 = 350p R1 = 4k C2 = 350p
SiPM 2x8
SiPM 2x8
