MatteoLonardiUNITN/Tesi-SPaRKLE/LTspice/Update/sipm_equivalente_controllo_tensione_pulse.asc

C1: cap; {Cq}
C2: cap; {Cd}
C3: cap; {(N-1)*Cq}
C4: cap; {(N-1)*Cd}
C5: cap; {Cg}
I1: current; PULSE(0 385m 0.1u 1p 1p 1n); AC 1
R2: res; {Rq/(N-1)}
RI: res; {Rq}
Named nets: A, K
