MatteoLonardiUNITN/Tesi-SPaRKLE/LTspice/Update/voltagemode_update.asc

C5: cap; 100n
C6: cap; 100n
C7: cap; 100n
C8: cap; 10n
C9: cap; 100p
C11: cap; 10p
C: cap; 100p
R3: res; 1k
R4: res; 390
R5: res; 51k
R6: res; 1k
R: res; 1Meg
U1: LT1803
V1: voltage; 26
V2: voltage; 3.3
V3: voltage; PULSE(0 35m 1u 10n 10n 10u 1m 1); Rser=50
X2: sipm_equivalente_controllo_tensione_pulse
Named nets: 0, vcc, signal, Vbias, Vcc, Vout
.param N=320000 Rq=1.13MEG Cq=397f Cd=18.1f Cg=29.12n
.tran 20u
SiPM 2x4
