MatteoLonardiUNITN/Tesi-SPaRKLE/LTspice/Update/voltagemode_update_current_SiPM.asc

C5: cap; 100n
C6: cap; 100n
C7: cap; 100n
C8: cap; 10n
C9: cap; 100p
C11: cap; 10p
C: cap; 100p
R3: res; 1k
R4: res; 390
R5: res; 51k
R6: res; 1k
R: res; 1Meg
U1: LT1803
V1: voltage; 26
V2: voltage; 3.3
X2: sipm_equivalente_controllo_tensione_pulse
Named nets: 0, vcc, signal, Vbias, Vcc, Vout
.param N=40000*4 Rq=1.13MEG Cq=397f Cd=18.1f Cg=2.95*4n
.tran 40u
SiPM 1x4
