MatteoLonardiUNITN/Tesi-SPaRKLE/(list of files, drawings)

Other design files:
LTspice/Convertitori/BD433M2.OLB
