MatteoLonardiUNITN/Tesi-SPaRKLE/Scheda/prova/prova.kicad_pcb

## KiCad design Scheda/prova/prova.kicad_pcb (2026-04-14)

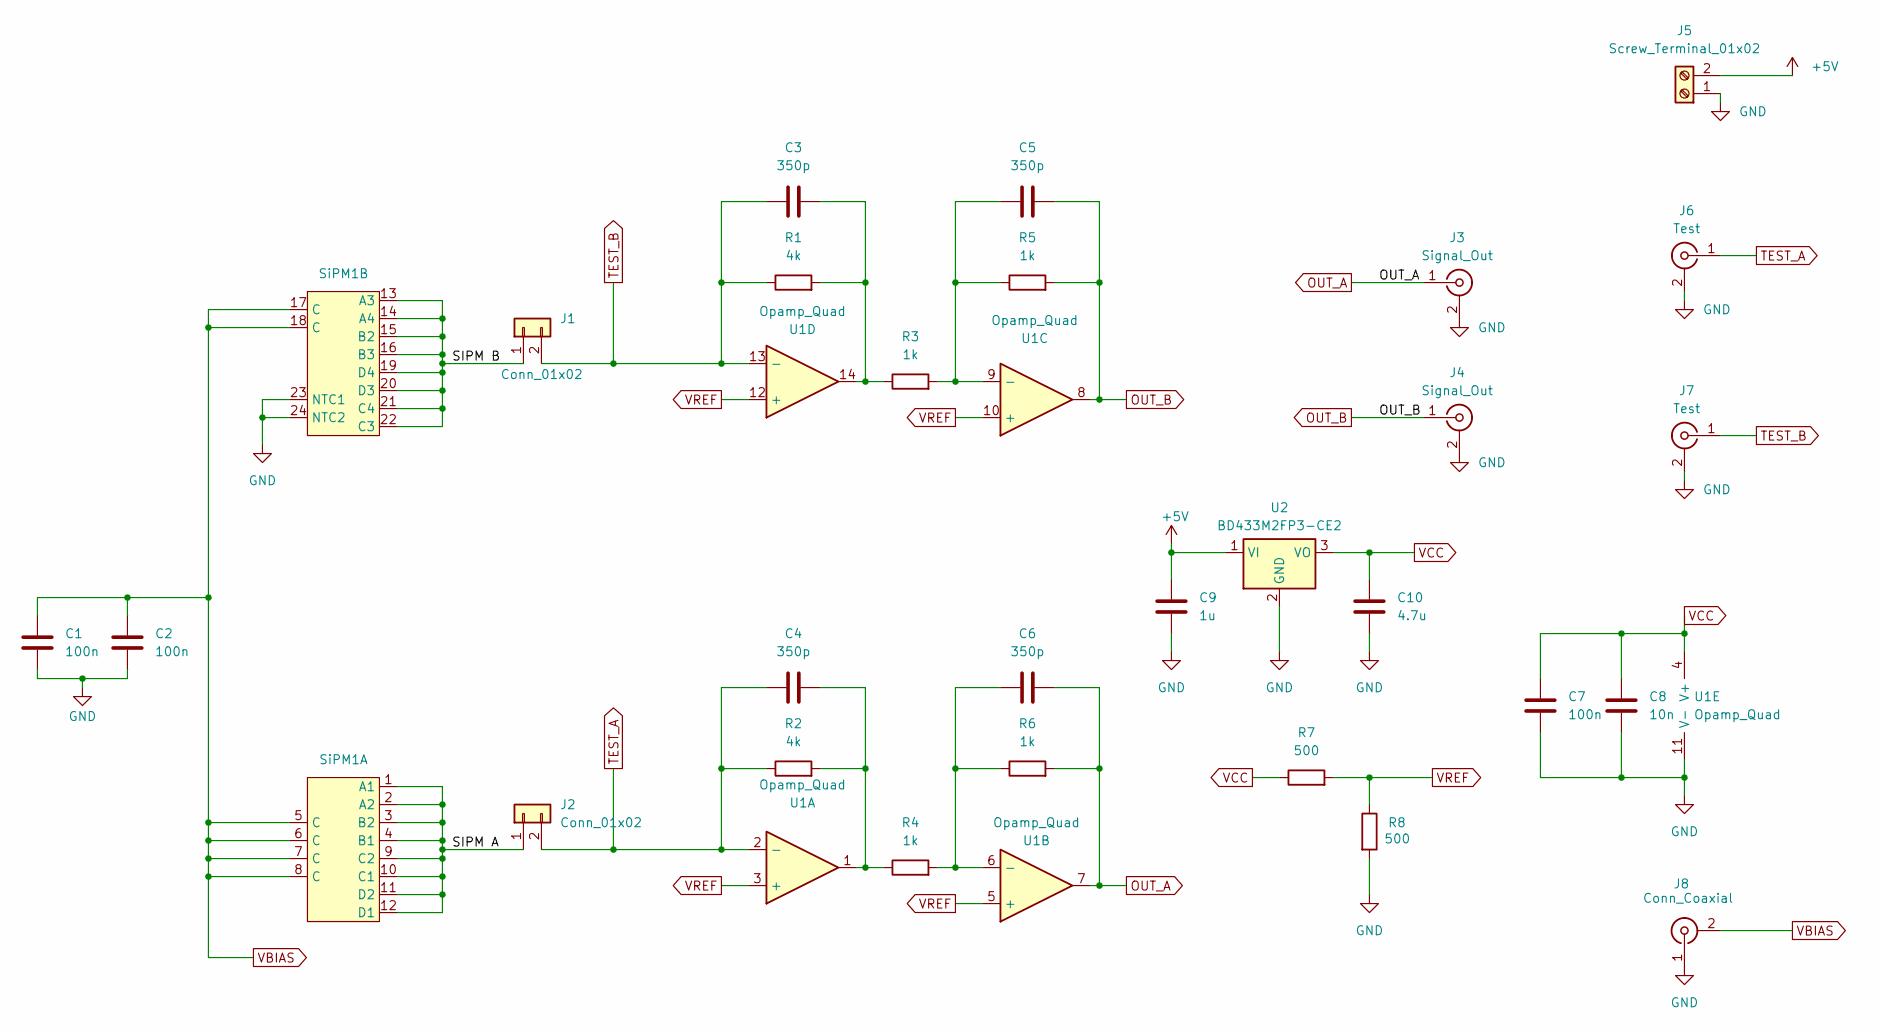
[picture p63: schematic prova.kicad_sch]

Parts:
C1, C2, C7: 100n; C_0603_1608Metric_Pad1.08x0.95mm_HandSolder
C3, C4, C5, C6: 350p; C_0603_1608Metric_Pad1.08x0.95mm_HandSolder
C8: 10n; C_0603_1608Metric_Pad1.08x0.95mm_HandSolder
C9: 1u; C_0603_1608Metric_Pad1.08x0.95mm_HandSolder
C10: 4.7u; C_0603_1608Metric_Pad1.08x0.95mm_HandSolder
J1, J2: Conn_01x02; PinHeader_1x02_P2.54mm_Vertical
J3, J4: Signal_Out; SMA_Horizontal
J5: Screw_Terminal_01x02; TerminalBlock_Altech_AK300-2_P5.00mm
J6, J7: Test; SMA_Horizontal
J8: Conn_Coaxial; BNC_Amphenol_B6252HB-NPP3G-50_Horizontal
R1, R2: 4k; R_0805_2012Metric_Pad1.20x1.40mm_HandSolder
R3, R4, R5, R6: 1k; R_0805_2012Metric_Pad1.20x1.40mm_HandSolder
R7, R8: 500; R_0805_2012Metric_Pad1.20x1.40mm_HandSolder
SiPM1: SiPM-Matrix
U1: Opamp_Quad; SOIC-14_3.9x8.7mm_P1.27mm
U2: BD433M2FP3-CE2; SOT-223-3_TabPin2

Connections:
+5V: C9.1, J5.2, U2.1 (VI)
/SIPM A: J2.1, SiPM1.1 (A1), SiPM1.2 (A2), SiPM1.3 (B2), SiPM1.4 (B1), SiPM1.9 (C2), SiPM1.10 (C1), SiPM1.11 (D2), SiPM1.12 (D1)
/SIPM B: J1.1, SiPM1.13 (A3), SiPM1.14 (A4), SiPM1.15 (B2), SiPM1.16 (B3), SiPM1.19 (D4), SiPM1.20 (D3), SiPM1.21 (C4), SiPM1.22 (C3)
GND: C1.2, C2.2, C7.2, C8.2, C9.2, C10.2, J3.2 (Ext), J4.2 (Ext), J5.1, J6.2 (Ext), J7.2 (Ext), J8.1 (In), R8.2, SiPM1.23 (NTC1), SiPM1.24 (NTC2), U1.11 (V-), U2.2 (GND)
unnamed: C3.2, R1.2, R3.1, U1.14
unnamed: C4.2, R2.2, R4.1, U1.1
unnamed: C6.1, R4.2, R6.1, U1.6 (-)
unnamed: C5.1, R3.2, R5.1, U1.9 (-)
OUT_A: C6.2, J3.1 (In), R6.2, U1.7
OUT_B: C5.2, J4.1 (In), R5.2, U1.8
TEST_A: C4.1, J2.2, J6.1 (In), R2.1, U1.2 (-)
TEST_B: C3.1, J1.2, J7.1 (In), R1.1, U1.13 (-)
VBIAS: C1.1, C2.1, J8.2 (Ext), SiPM1.5 (C), SiPM1.6 (C), SiPM1.7 (C), SiPM1.8 (C), SiPM1.17 (C), SiPM1.18 (C)
VCC: C7.1, C8.1, C10.1, R7.1, U1.4 (V+), U2.3 (VO)
VREF: R7.2, R8.1, U1.3 (+), U1.5 (+), U1.10 (+), U1.12 (+)

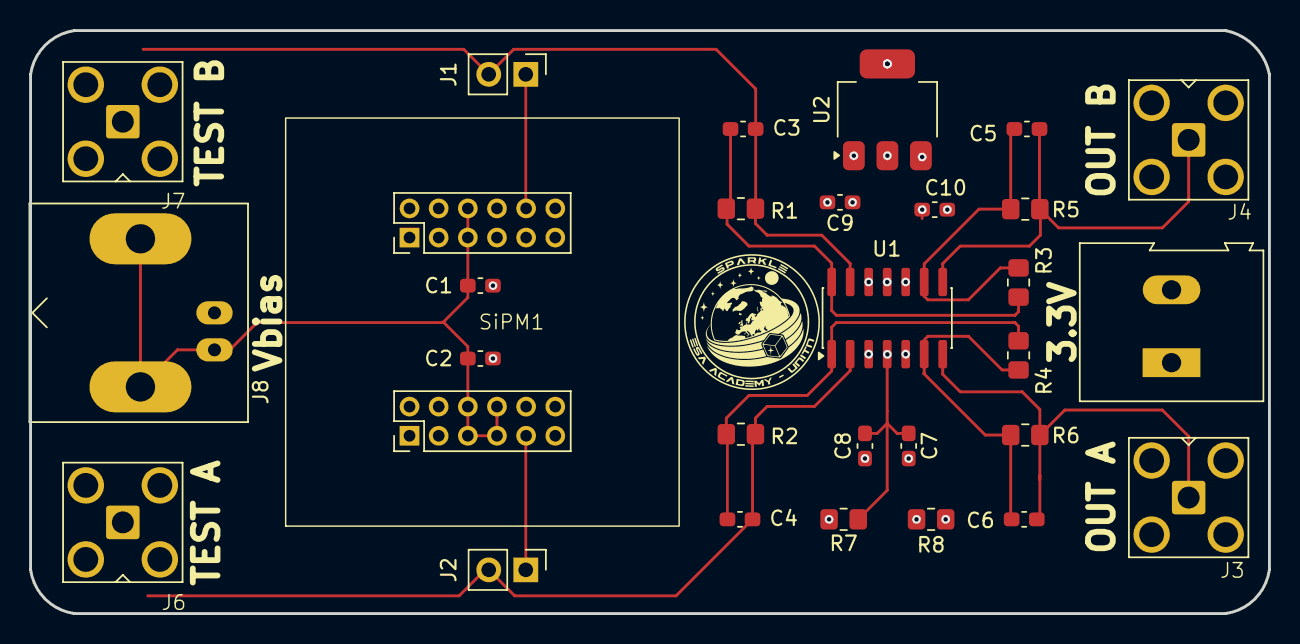
[picture p64: board prova.kicad_pcb from above]

Board: 2 copper layers, 85.0 x 40.0 mm, 29 parts (0 on the bottom side), 15 nets.
