MatteoLonardiUNITN/Tesi-SPaRKLE/(commit log)

2026-04-13 Primo Upload
    Primo upload dei tutti i file fin'ora per la tesi
    [prova.kicad_pcb, prova.kicad_sch]
2026-04-13 Convronto V I
    Confronto tra i segnali in uscita ai circuiti controllotensione e controllocorrente con analisi Trise e Tfall
2026-04-14 Aggiunta modelli 3D e regolatore
    [ARRAYJ-30035-16P-PCB.step, BD433M2.OLB, Download_STP_691213510002_rev1.stp, HJ-Tech-HJ-SMA175.STEP, dati.csv, impulso_esterno+sipm.csv, impulso_esterno+sipm_1.csv, impulso_esterno_1.csv]
